wedsamuel1230/CTEA-BottleSumo/software/CAR/CAR_final/CAR_final_v2/README.md

# CAR_final - Dual-Core BottleSumo Robot

## Overview

This folder contains the complete implementation of a competition-ready bottle sumo robot using a dual-core architecture on the Raspberry Pi Pico W (RP2040).

## Quick Start

### 1. Hardware Requirements
- Raspberry Pi Pico W (RP2040)
- 2× DC Motors with H-Bridge drivers
- 5× VL53L0X Time-of-Flight sensors
- 1× ADS1115 16-bit ADC
- 4× QRE1113 IR reflectance sensors
- 2× Push buttons (optional, for test modes)
- Power supply (battery)

### 2. Upload Code
```bash
# Option A: Arduino IDE
Open CAR_final_v2.ino → Select "Raspberry Pi Pico W" → Upload

# Option B: arduino-cli
arduino-cli compile --fqbn rp2040:rp2040:rpipicow CAR_final_v2.ino
arduino-cli upload -p /dev/ttyACM0 --fqbn rp2040:rp2040:rpipicow
```

### 3. Connect & Monitor
```bash
# Serial monitor
screen /dev/ttyACM0 115200

# WiFi telemetry
nc 192.168.4.1 8080
```

### 4. Operation
1. Power on robot
2. Wait for "Ready" messages
3. Place in arena
4. Robot starts automatically after 3 seconds

## File Structure

```
CAR_final/
├── README.md                      # This file
├── CAR_final.ino                  # Original implementation (v1)
├── CAR_final_v2.ino              # NEW: Dual-core architecture (v2) ⭐
│
├── Car.cpp / Car.h                # Motor control abstraction
├── Motor.cpp / Motor.h            # Low-level PWM motor driver
├── ToFArray.cpp / ToFArray.h      # VL53L0X sensor array manager
├── Ads1115Sampler.cpp / .h        # ADS1115 ADC interface
├── ButtonManager.h                # Button debouncing utility
│
├── IMPLEMENTATION_SUMMARY.md      # High-level summary
├── DUAL_CORE_ARCHITECTURE.md      # Detailed architecture docs
├── MIGRATION_GUIDE.md             # v1 → v2 migration guide
├── QUICK_REFERENCE.md             # Developer quick reference
└── ARCHITECTURE_DIAGRAMS.md       # Visual diagrams
```

## Architecture

### Core 0: Pure State Machine (100Hz)
- **Input**: Sensor data from shared memory
- **Processing**: Decision logic (edge detection, target tracking)
- **Output**: Motor commands to shared memory
- **No I/O operations** - deterministic timing

### Core 1: Time-Sliced I/O Scheduler (500ms cycle)
- **10 time slots** @ 50ms each
- **IR sensors**: Read 4× per cycle (200Hz)
- **ToF sensors**: Read 1× per cycle per sensor (2Hz)
- **Motors**: Updated 2× per cycle
- **WiFi**: Telemetry broadcast 2× per cycle

### Shared Memory (Mutex-Protected)
```cpp
SensorData       // Core 1 → Core 0
MotorCommand     // Core 0 → Core 1
TelemetryData    // Both → WiFi
```

## Key Features

✅ **Non-blocking** - No blocking operations, smooth performance  
✅ **Deterministic** - Predictable timing for competition reliability  
✅ **Separation of Concerns** - Logic isolated from I/O  
✅ **Scalable** - Easy to add new features  
✅ **Robust** - Mutex-protected shared memory  
✅ **Maintainable** - Clean, well-documented code  
✅ **WiFi Telemetry** - Real-time monitoring and debugging  

## Pin Configuration

### Motors
```
Left Motor:  PWM=11, DIR=12
Right Motor: PWM=14, DIR=15
```

### ToF Sensors (I2C on Wire1)
```
SDA=2, SCL=3
XSHUT Pins: {8, 7, 6, 5, 4}
Addresses: {0x30, 0x31, 0x32, 0x33, 0x34}
Layout: [R45°, R23°, Center, L23°, L45°]
```

### IR Sensors (ADS1115 on Wire1)
```
Address: 0x48
Channels:
  A0 = Back-Left
  A1 = Front-Left
  A2 = Front-Right
  A3 = Back-Right
```

### Buttons (Optional)
```
Test Mode: Pin 16
Run Mode:  Pin 17
```

## States & Behavior

### State Machine
1. **IDLE** - Waiting for start command
2. **SEARCHING** - Spinning to find opponent
3. **TRACKING** - Aligning with target
4. **ATTACKING** - Full-speed forward attack
5. **EDGE_AVOIDING** - Emergency edge escape
6. **CALIBRATING** - Sensor calibration mode

### Priority System
```
1. Edge Detection ────────────► (Highest)
2. Target Tracking
3. Search Pattern ─────────────► (Default)
```

## Performance

### Response Times
- **Edge Detection**: 127-377ms
- **Target Tracking**: 450-703ms
- **State Transition**: <1ms

### CPU Utilization
- **Core 0**: ~1% (pure logic)
- **Core 1**: ~40% (all I/O)

### Sensor Update Rates
- **IR**: 200Hz (continuous)
- **ToF**: 2Hz per sensor
- **Motors**: 2Hz command updates

## WiFi Telemetry

### Connection
```
SSID:     BottleSumo_AP
Password: sumobot123456
IP:       192.168.4.1
Port:     8080
```

### JSON Format
```json
{
  "t": 12345,
  "ir": [0.12, 1.45, 1.50, 0.10],
  "tof": [120, 115, 110, 118, 125],
  "m": [35.0, 35.0],
  "s": 3
}
```

### Python Client Example
```python
import socket
import json

sock = socket.socket()
sock.connect(('192.168.4.1', 8080))

while True:
    data = sock.recv(1024).decode()
    for line in data.split('\n'):
        if line:
            telem = json.loads(line)
            print(f"State: {telem['s']}, Center ToF: {telem['tof'][2]}mm")
```

## Tuning Parameters

Located in `CAR_final_v2.ino`:

```cpp
// Detection
IR_THRESHOLD_FRONT = 1.5f   // Edge detection (volts)
IR_THRESHOLD_BACK = 3.0f    // Edge detection (volts)
DETECT_MIN_MM = 70          // Min ToF distance
DETECT_MAX_MM = 1000        // Max ToF distance

// Behavior
ESCAPE_SPEED = 50.0f        // Edge escape speed
ATTACK_SPEED = 100.0f       // Full attack speed
SEARCH_SPIN_SPEED = 35.0f   // Search rotation speed

// Timing
TIME_SLICE_MS = 50          // I/O slot duration
```

## Troubleshooting

### Motors Don't Respond
```bash
# Check Serial Monitor
Expected: "[CORE1] Motors OK"

# If failed:
1. Check motor pin connections
2. Verify power supply
3. Test motors independently
```

### Sensors Show Invalid
```bash
# Check Serial Monitor
Expected: "[CORE1] ToF sensors online: 5/5"
Expected: "[CORE1] ADS1115 OK"

# If failed:
1. Check I2C connections (SDA=2, SCL=3)
2. Verify sensor power
3. Run I2C scanner
```

### WiFi Won't Connect
```bash
# Check Serial Monitor
Expected: "[CORE1] WiFi AP: 192.168.4.1"

# If failed:
1. Check antenna connected
2. Verify SSID not conflicting
3. Try different channel
```

### Robot Stuck in One State
```bash
# Enable debug mode
In stateMachineUpdate(), add:
Serial.printf("State: %d, Edge: %d, Target: %d\n", 
              (int)gStateMachine.currentState, 
              edgeDetected, 
              targetDetected);
```

## Testing Checklist

- [ ] Compile without errors
- [ ] All sensors initialize (check Serial Monitor)
- [ ] Motors respond to commands
- [ ] WiFi AP visible
- [ ] Telemetry streams over WiFi
- [ ] Edge detection triggers avoidance
- [ ] Target tracking changes state
- [ ] 1-hour continuous operation
- [ ] Competition arena validation

## Documentation

### Quick Start
- **README.md** (this file) - Overview and quick start

### Development
- **QUICK_REFERENCE.md** - API, pins, parameters
- **ARCHITECTURE_DIAGRAMS.md** - Visual architecture diagrams

### Deep Dive
- **DUAL_CORE_ARCHITECTURE.md** - Complete design documentation
- **IMPLEMENTATION_SUMMARY.md** - High-level summary

### Migration
- **MIGRATION_GUIDE.md** - Upgrade from v1 to v2

## Version History

| Version | Date | Description |
|---|---|---|
| v1 | Original | Blocking architecture, mixed I/O and logic |
| v2 | Current | Dual-core time-sliced, pure state machine |

## Contributing

When modifying this code:

1. **Core 0 changes**: Pure logic only, no I/O
2. **Core 1 changes**: Ensure tasks fit in 50ms slots
3. **Shared memory**: Always use mutex protection
4. **Testing**: Validate timing with Serial Monitor
5. **Documentation**: Update relevant .md files

## Competition Tips

1. **Calibrate sensors** in the actual arena lighting
2. **Tune thresholds** for your arena surface
3. **Test edge detection** at all angles
4. **Validate target tracking** at various distances
5. **Run endurance tests** before competition
6. **Have backup configuration** ready

## Support

For issues or questions:

1. Check Serial Monitor output
2. Review QUICK_REFERENCE.md
3. Read DUAL_CORE_ARCHITECTURE.md
4. Check MIGRATION_GUIDE.md
5. Review code comments

## License

See LICENSE file in repository root.

## Credits

Developed for CTEA BottleSumo Competition

---

**Ready to compete! 🤖🥋**

For detailed architecture information, see **DUAL_CORE_ARCHITECTURE.md**  
For API reference, see **QUICK_REFERENCE.md**  
For migration help, see **MIGRATION_GUIDE.md**
