wedsamuel1230/CTEA-BottleSumo/software/BottleSumo_TimeSliced/edge_detection_architecture.png

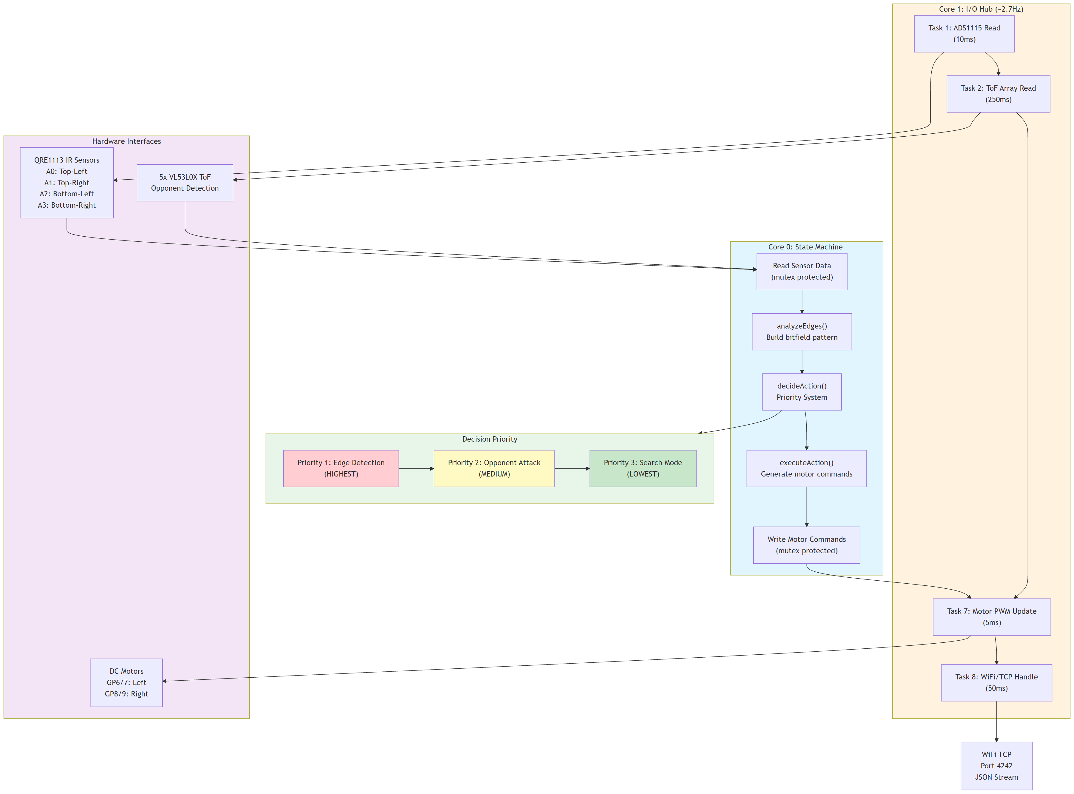
software/BottleSumo_TimeSliced/edge_detection_architecture.png
