wedsamuel1230/CTEA-BottleSumo/software/BottleSumo_TimeSliced/edge_pattern_flow.png

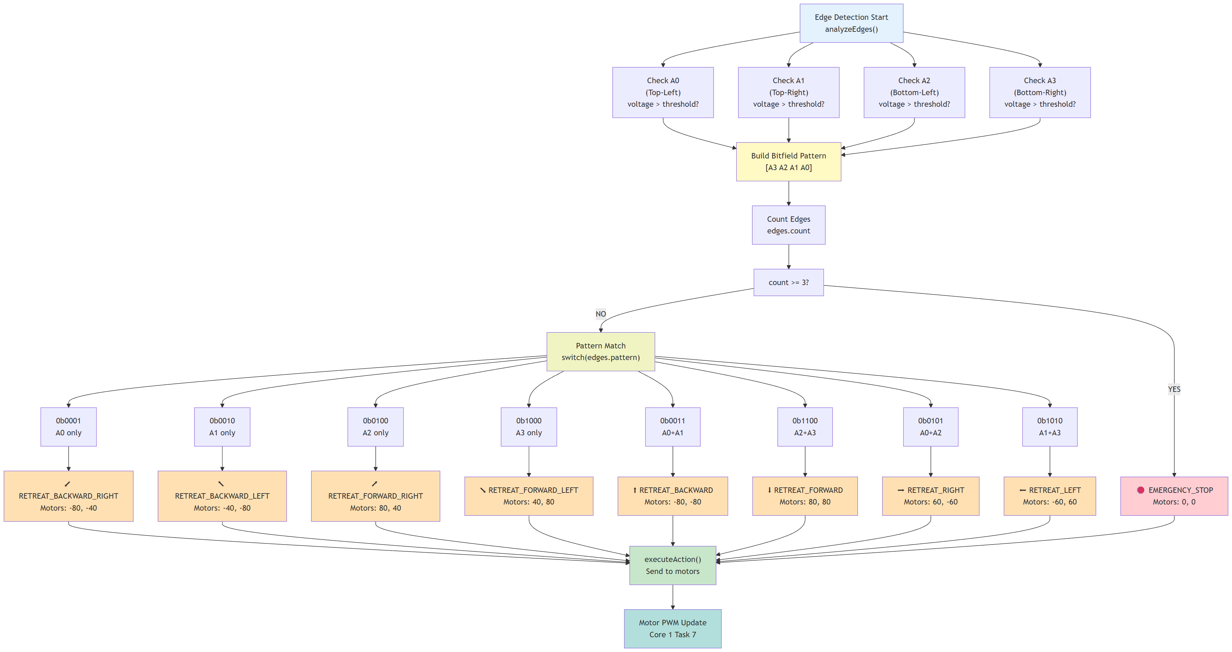
software/BottleSumo_TimeSliced/edge_pattern_flow.png
