wedsamuel1230/CTEA-BottleSumo/3dmodel/Car1_Front_Cover.obj

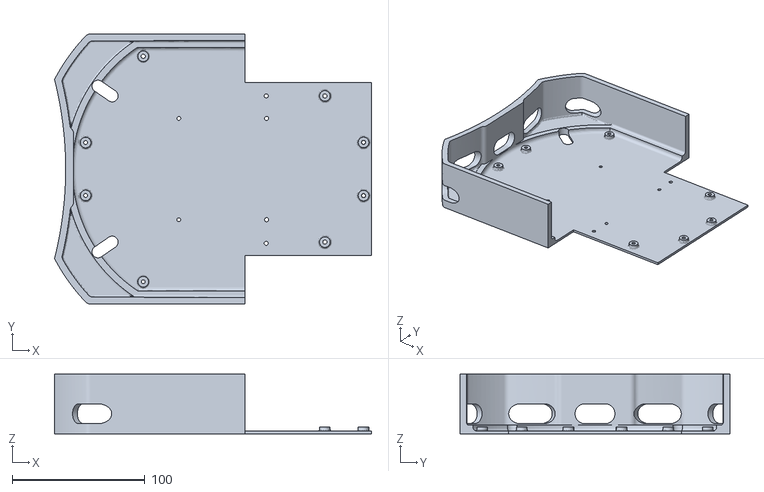
[picture p3: CAD file, 2025-12-06]
3dmodel/Car1_Front_Cover.obj
238.5 x 203.1 x 44.8
