wedsamuel1230/CTEA-BottleSumo/3dmodel/Car2_Front_Cover.obj

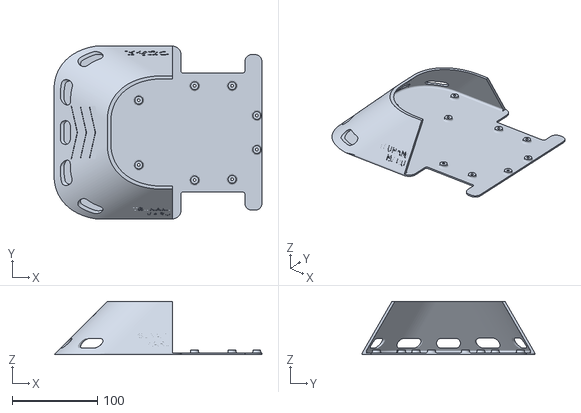
[picture p4: CAD file, 2025-12-06]
3dmodel/Car2_Front_Cover.obj
244.6 x 203.1 x 62.7
