wedsamuel1230/CTEA-BottleSumo/3dmodel/Car_Back_Cover.obj

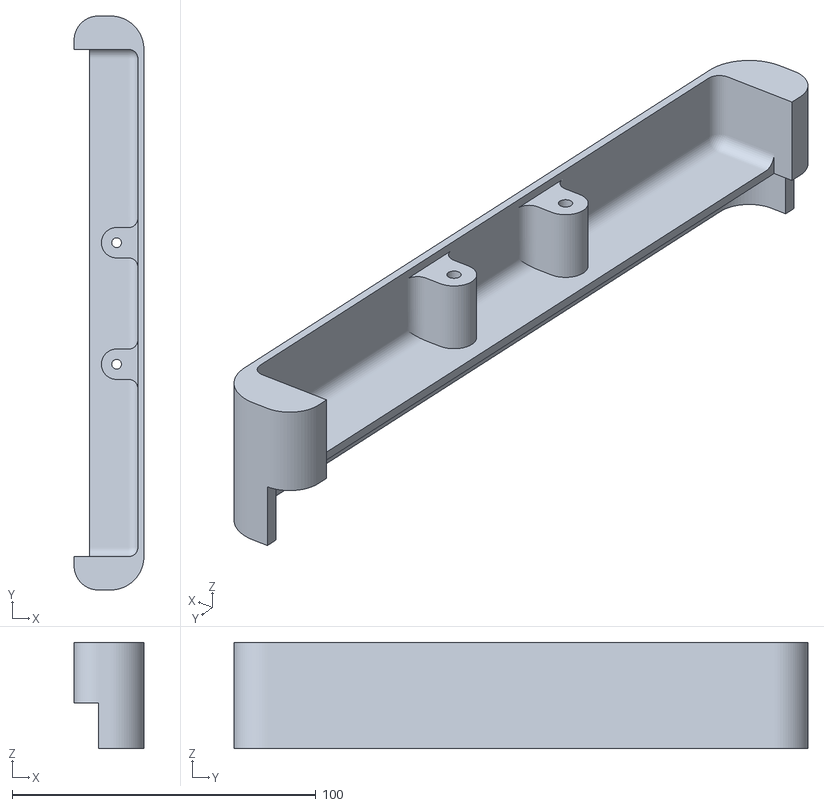
[picture p5: CAD file, 2025-12-06]
3dmodel/Car_Back_Cover.obj
23.0 x 189.0 x 35.0
