wedsamuel1230/CTEA-BottleSumo/pcb/main board.pdf

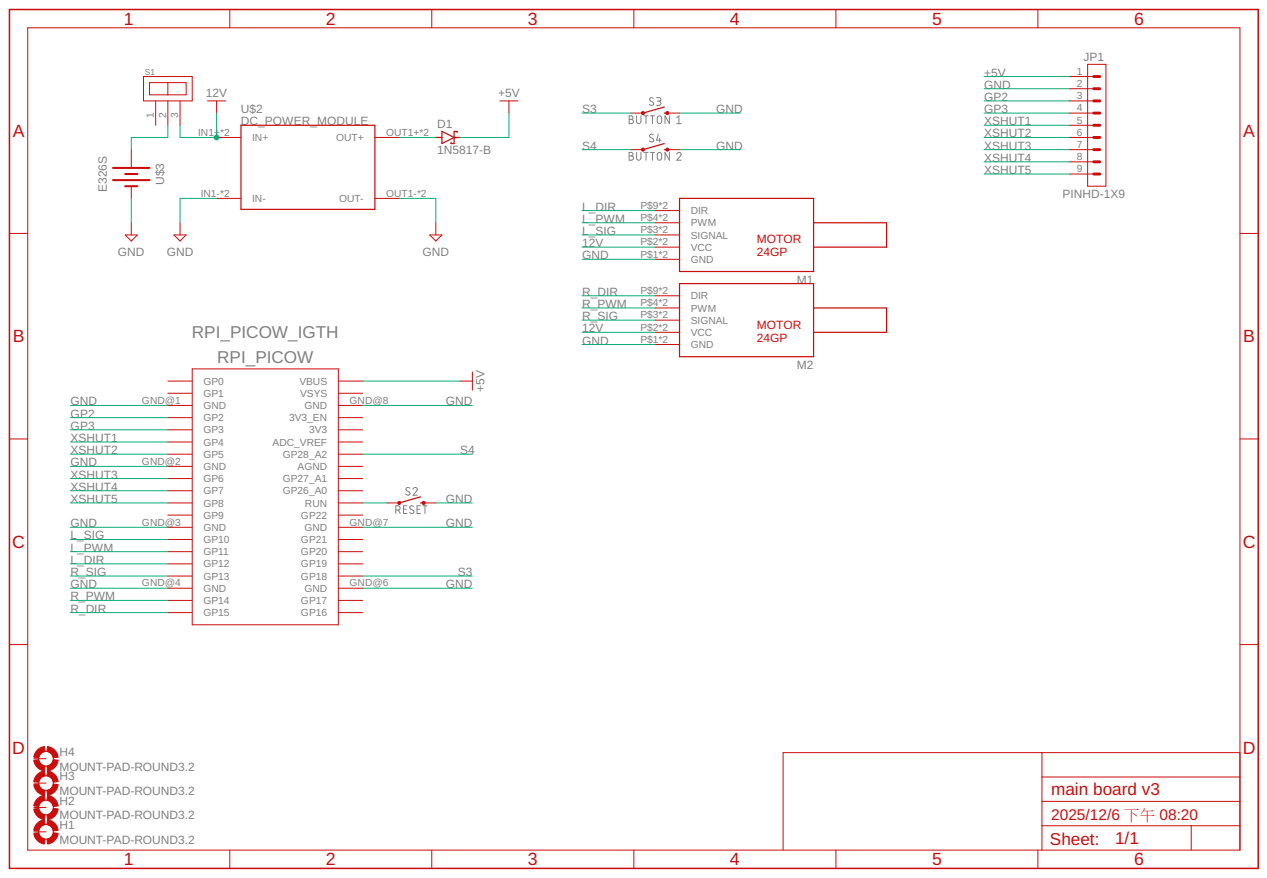
[picture p6: page 1]
DC_POWER_MODULE GND; GND E³²⁶S GND; +5V 1N5817-B+5V 12V MOUNT-PAD-ROUND3.2 MOUNT-PAD-ROUND3.2 MOUNT-PAD-ROUND3.2 MOUNT-PAD-ROUND3.2; PINHD-1X9 RPI_PICOW_IGTH GP0 GP1 GP2 GP3 GP4 GP5 GP6 GP7 GP8 GP9 GP10 GP11 GP12 GP13 GP14 GP15; GP16 GP17 GP18 GP19 GP20 GP21 GP22 RUN GP26_A0 GP27_A1 AGND GP28_A2 ADC_VREF 3V3 3V3_EN VSYS VBUS GND GND@1; GND GND@2; GND GND@3; GND GND@4; GND; GND@6 GND; GND@7 GND; GND@8 RPI_PICOW U$2IN+ IN1+*2; OUT-; OUT1-*2 OUT+; OUT1+*2 S11; M1 SIGNAL P$3*2; VCC P$2*2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

76.18

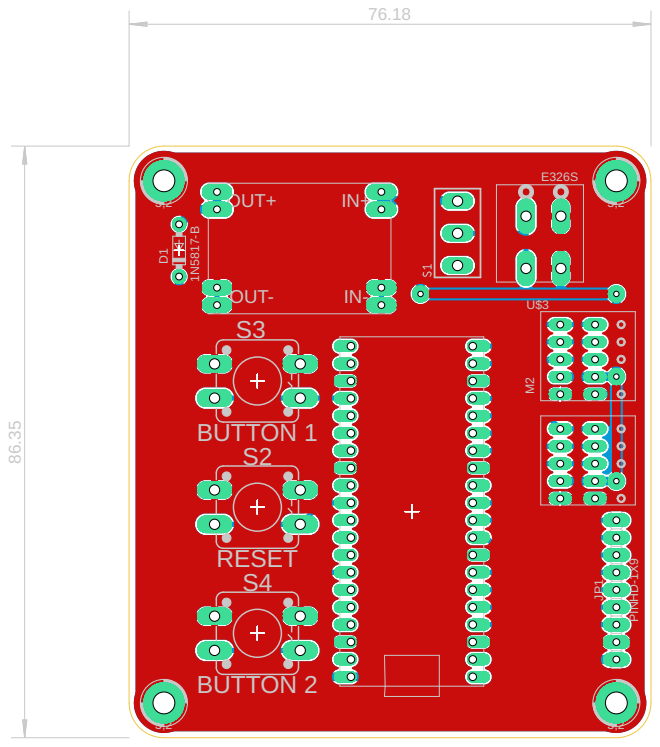
[picture p7: page 2]
OUT-; IN- OUT+; RESET; BUTTON 1; BUTTON 2; PINHD-1X9
