wedsamuel1230/CTEA-BottleSumo/pcb/sensor board.pdf

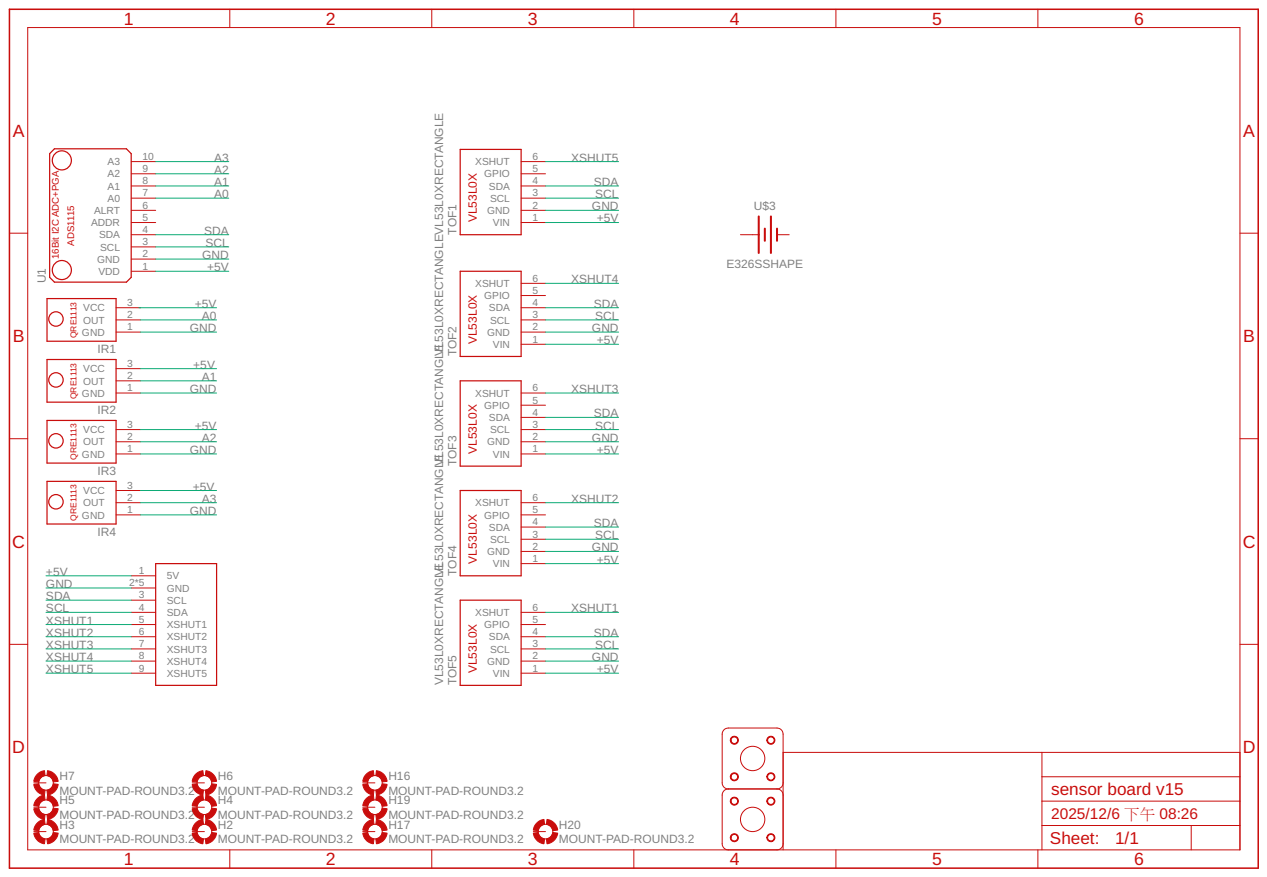
[picture p8: page 1]
MOUNT-PAD-ROUND3.2; VL53L0XRECTANGLE VL53L0XRECTANGLE VL53L0XRECTANGLE VL53L0XRECTANGLE VL53L0XRECTANGLE MOUNT-PAD-ROUND3.2; E326SSHAPE MOUNT-PAD-ROUND3.2 MOUNT-PAD-ROUND3.2; MOUNT-PAD-ROUND3.2 MOUNT-PAD-ROUND3.2 MOUNT-PAD-ROUND3.2; MOUNT-PAD-ROUND3.2 U¹; 7 ALRT; 6 ADDR; 5 SDA; 4 SCL; 3 GND; 2 VDD; 1 IR1 GND; 1 OUT; 2 VCC; 3 IR2 GND; 3 IR3 GND; 3 IR4 GND; GND 2*5; SCL 3; SDA 4; XSHUT1 5; XSHUT2 6; XSHUT3 7; XSHUT4 8; XSHUT5 9 H3; TOF1; VIN; 1 GND; 2 SCL; 3 SDA; 4 GPIO; 5 XSHUT; 6 TOF2; 6 TOF3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

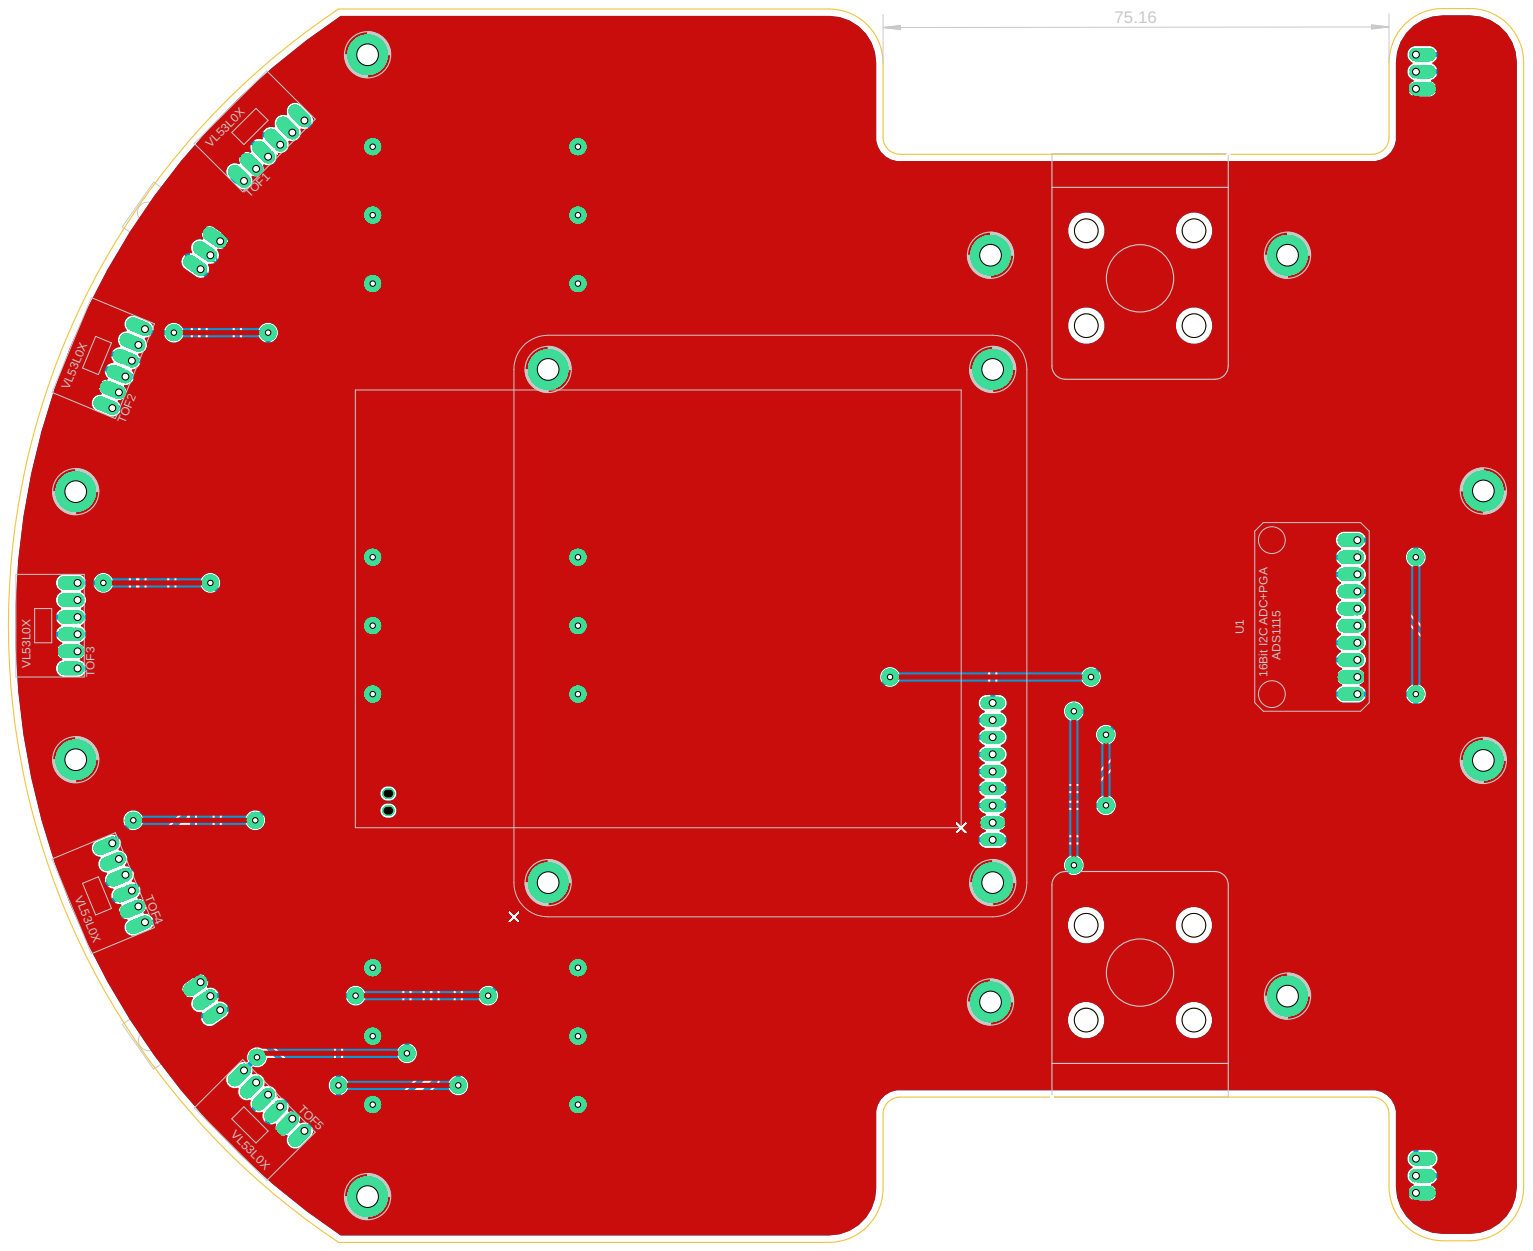
[picture p9: page 2]

1 RI RI 2 RI 3 4 RI QRE1113 QRE1 3 QRE1 3 QRE1113 16Bit I2C ADC+PGA ADS1115 VL53L0X VL53L0X VL53L0X VL53L0X VL53L0X U1 TOF1 TOF2 TOF3 TOF4 TOF5 75.16
