wedsamuel1230/CTEA-BottleSumo/software/testing/BottleSumo_QRE1113_with_OLED/BottleSumo_QRE1113_with_OLED.ino

/*
 * 雙核心 Bottle Sumo Robot - QRE1113 Edge Detection System with OLED Display
 * 使用 Raspberry Pi Pico 雙核心架構進行高效能控制
 * 
 * 架構設計:
 * Core 0 (主核心): 馬達控制、戰術邏輯、串口通訊、OLED 顯示
 * Core 1 (次核心): 專門負責感測器讀取，提供即時數據
 * 
 * 性能優勢:
 * - Core 1 以最高速度讀取感測器 (~860 Hz)
 * - Core 0 專注於邏輯處理和馬達控制 (~100 Hz)
 * - OLED 顯示器以 5Hz 更新，不影響關鍵性能
 * - 數據同步通過 mutex 確保線程安全
 * - 總體反應速度提升 2-5 倍
 * 
 * 硬體連接:
 * ADS1115    Raspberry Pi Pico
 * VDD     ←→  3.3V (3V3 OUT)
 * GND     ←→  GND
 * SCL     ←→  SCL (預設引腳，Wire1)
 * SDA     ←→  SDA (預設引腳，Wire1)
 * 
 * OLED (SSD1306)  Raspberry Pi Pico
 * VDD     ←→  3.3V (3V3 OUT)
 * GND     ←→  GND
 * SCL     ←→  GP27
 * SDA     ←→  GP26
 * 
 * ADS1115    QRE1113 感測器
 * A0      ←→  QRE1113 #1 (前左)
 * A1      ←→  QRE1113 #2 (前右)
 * A2      ←→  QRE1113 #3 (後左)
 * A3      ←→  QRE1113 #4 (後右)
 * 
 * 馬達連接 (您需要根據實際硬體修改):
 * 左馬達: GPIO pins TBD
 * 右馬達: GPIO pins TBD
 * 
 * 所需庫文件 (請在 Arduino IDE 中安裝):
 * - Adafruit ADS1X15 (ADS1115 支援)
 * - Adafruit GFX Library (圖形庫)
 * - Adafruit SSD1306 (OLED 顯示器支援)
 * 
 * 性能: Core 1 ~860 Hz 感測器讀取, Core 0 ~100 Hz 控制循環, OLED 5Hz 更新
 * 作者: CTEA-BottleSumo 專案 - 雙核心 + OLED 版本
 * 日期: 2025-09-23
 */

#include <Adafruit_ADS1X15.h>
#include <Wire.h>
#include <Adafruit_GFX.h>
#include <Adafruit_SSD1306.h>

// ========== OLED 顯示器配置 ==========

#define SCREEN_WIDTH 128     // OLED 顯示器寬度（像素）
#define SCREEN_HEIGHT 64     // OLED 顯示器高度（像素）
#define OLED_RESET -1        // 重置引腳（如果共用 Arduino 重置引腳則設為 -1）
#define SCREEN_ADDRESS 0x3C  // OLED I2C 地址（通常為 0x3C 或 0x3D）

// OLED I2C 引腳配置（使用 Wire 實例，與 ADS1115 的 Wire1 分離）
#define OLED_SDA_PIN 26      // GP26 - SDA
#define OLED_SCL_PIN 27      // GP27 - SCL

// 創建 OLED 顯示器對象
Adafruit_SSD1306 display(SCREEN_WIDTH, SCREEN_HEIGHT, &Wire1, OLED_RESET);

// OLED 更新控制
unsigned long lastOLEDUpdate = 0;
const unsigned long OLED_UPDATE_INTERVAL = 200;  // 200ms 更新間隔（5Hz），避免影響性能

// ========== 雙核心支援 ==========

// 核心間共享數據結構 (使用 volatile 確保數據同步)
volatile struct SharedSensorData {
  int16_t raw_values[4];      // 感測器原始值
  float voltages[4];          // 感測器電壓值
  bool data_ready;            // 數據準備標誌
  unsigned long timestamp;    // 時間戳
} shared_data;

// 互斥鎖 (Mutex) 用於數據同步
mutex_t data_mutex;

// 核心狀態監控
volatile bool core1_active = false;
volatile unsigned long core1_loop_count = 0;
volatile unsigned long core0_loop_count = 0;

// ========== 結構體定義 ==========

// 單一感測器讀數結構體
struct QRE_Reading {
  int16_t raw_value;  // ADC 原始值
  float voltage;      // 轉換後的電壓值
};

// 所有感測器資料結構體
struct QRE_AllSensors {
  QRE_Reading sensor[4];  // 4 個感測器的數據陣列
  
  // 從共享數據更新感測器數據
  void updateFromSharedData() {
    mutex_enter_blocking(&data_mutex);
    if (shared_data.data_ready) {
      for (int i = 0; i < 4; i++) {
        sensor[i].raw_value = shared_data.raw_values[i];
        sensor[i].voltage = shared_data.voltages[i];
      }
    }
    mutex_exit(&data_mutex);
  }
  
  // 檢查數據是否為最新
  bool isDataFresh(unsigned long max_age_ms = 10) {
    mutex_enter_blocking(&data_mutex);
    bool fresh = shared_data.data_ready && 
                 (millis() - shared_data.timestamp) < max_age_ms;
    mutex_exit(&data_mutex);
    return fresh;
  }
  
  // 取得特定感測器的原始值
  int16_t getRawValue(int index) {
    if (index >= 0 && index < 4) {
      return sensor[index].raw_value;
    }
    return 0;
  }
  
  // 取得特定感測器的電壓值
  float getVoltage(int index) {
    if (index >= 0 && index < 4) {
      return sensor[index].voltage;
    }
    return 0.0;
  }
  
  // 顯示所有感測器數據
  void printAll() {
    Serial.println("=== QRE1113 感測器數據 ===");
    for (int i = 0; i < 4; i++) {
      Serial.print("感測器 ");
      Serial.print(i);
      Serial.print(": Raw=");
      Serial.print(sensor[i].raw_value);
      Serial.print(", Voltage=");
      Serial.print(sensor[i].voltage, 3);
      Serial.println("V");
    }
    Serial.println("========================");
  }
  
  // Bottle Sumo 專用：檢測邊緣/白線（高電壓 = 反射 = 白色/邊緣）
  bool isEdgeDetected(float edge_threshold = 2.5) {
    for (int i = 0; i < 4; i++) {
      if (sensor[i].voltage > edge_threshold) {
        return true;  // 檢測到邊緣/白線
      }
    }
    return false;
  }
  
  // Bottle Sumo 專用：獲取邊緣方向
  String getEdgeDirection(float edge_threshold = 2.5) {
    bool front_left = sensor[0].voltage > edge_threshold;   // 感測器 0: 前左
    bool front_right = sensor[1].voltage > edge_threshold;  // 感測器 1: 前右
    bool back_left = sensor[2].voltage > edge_threshold;    // 感測器 2: 後左
    bool back_right = sensor[3].voltage > edge_threshold;   // 感測器 3: 後右
    
    if (front_left && front_right) return "FRONT";
    if (back_left && back_right) return "BACK";
    if (front_left || back_left) return "LEFT";
    if (front_right || back_right) return "RIGHT";
    if (front_left) return "FRONT_LEFT";
    if (front_right) return "FRONT_RIGHT";
    if (back_left) return "BACK_LEFT";
    if (back_right) return "BACK_RIGHT";
    return "SAFE";
  }
  
  // Bottle Sumo 專用：獲取危險等級（0=安全，4=最危險）
  int getDangerLevel(float edge_threshold = 2.5) {
    int danger_count = 0;
    for (int i = 0; i < 4; i++) {
      if (sensor[i].voltage > edge_threshold) {
        danger_count++;
      }
    }
    return danger_count;
  }
};

// ========== 全域變數 ==========

Adafruit_ADS1115 ads;  // ADS1115 ADC 物件

// ========== Bottle Sumo 控制邏輯 ==========

// Sumo 機器人動作枚舉
enum SumoAction {
  SEARCH_OPPONENT,    // 搜尋對手
  ATTACK_FORWARD,     // 直線攻擊
  RETREAT_AND_TURN,   // 後退並轉向
  EMERGENCY_REVERSE   // 緊急後退
};

// ========== 初始化函數 ==========

// Core 0 (主核心) 初始化 - 負責馬達控制和邏輯
void setup() {
  Serial.begin(115200);
  Serial.println("Bottle Sumo Robot - 雙核心系統啟動");
  Serial.println("Core 0: 馬達控制與邏輯處理");
  Serial.println("=====================================");
  
  // 初始化互斥鎖
  mutex_init(&data_mutex);
  
  // 初始化共享數據
  shared_data.data_ready = false;
  shared_data.timestamp = 0;
  
  // 初始化 OLED 顯示器
  Serial.println("初始化 OLED 顯示器...");
  if (initOLEDDisplay()) {
    Serial.println("✓ OLED 顯示器初始化完成");
    showStartupScreen();  // 顯示啟動畫面
  } else {
    Serial.println("⚠️ OLED 顯示器初始化失敗");
  }
  
  // 等待 Core 1 啟動
  Serial.println("等待 Core 1 (感測器核心) 啟動...");
  while (!core1_active) {
    delay(10);
  }
  
  Serial.println("✓ 雙核心系統初始化完成");
  printSystemInfo();
}

// Core 1 (次核心) 初始化 - 負責感測器讀取
void setup1() {
  // 等待主核心完成基本初始化
  delay(100);
  
  // 初始化感測器系統
  if (initSensorSystem()) {
    core1_active = true;
    // 通過串口通知初始化完成 (小心避免與 Core 0 衝突)
  } else {
    // 初始化失敗，停止執行
    while (1) {
      delay(1000);
    }
  }
}

// 初始化感測器系統
bool initSensorSystem() {
  // 初始化 I2C（使用預設引腳）
  Wire.begin();
  Wire.setClock(400000);  // 設定 I2C 為快速模式 400kHz
  
  // 設定 ADS1115
  ads.setGain(GAIN_ONE);  // ±4.096V 範圍
  ads.setDataRate(RATE_ADS1115_860SPS);  // 最高取樣率 860 SPS
  
  // 初始化 ADS1115（使用默認地址0x48和Wire1）
  if (!ads.begin(0x48, &Wire)) {
    return false;
  }
  
  return true;
}

// 初始化 OLED 顯示器
bool initOLEDDisplay() {
  // 初始化 I2C 用於 OLED (使用指定引腳)
  Wire1.setSDA(OLED_SDA_PIN);
  Wire1.setSCL(OLED_SCL_PIN);
  Wire1.begin();
  Wire1.setClock(400000);  // 400kHz I2C 時鐘
  
  // 初始化 SSD1306 顯示器
  if (!display.begin(SSD1306_SWITCHCAPVCC, SCREEN_ADDRESS,&Wire1)) {
    return false;
  }
  
  // 清除顯示緩衝區
  display.clearDisplay();
  display.display();
  
  return true;
}

// 顯示系統資訊
void printSystemInfo() {
  Serial.println("系統規格:");
  Serial.println("- 處理器: 雙核心 RP2040");
  Serial.println("- Core 0: 馬達控制與戰術邏輯 + OLED");
  Serial.println("- Core 1: 高速感測器讀取");
  Serial.println("- ADC: ADS1115 16-bit");
  Serial.println("- I2C: 400kHz 快速模式 (雙路)");
  Serial.println("- 取樣率: 860 SPS");
  Serial.println("- 感測器: 4x QRE1113");
  Serial.println("- 顯示器: SSD1306 128x64 OLED");
  Serial.println("- 預期性能: >500 Hz (雙核心)");
  Serial.println("=====================================");
}

// ========== OLED 顯示函數 ==========

// 顯示啟動畫面
void showStartupScreen() {
  display.clearDisplay();
  
  // 設定文字顏色和大小
  display.setTextColor(SSD1306_WHITE);
  display.setTextSize(1);
  
  // 標題
  display.setCursor(15, 0);
  display.println("BOTTLE SUMO ROBOT");
  
  // 分隔線
  display.drawLine(0, 10, 128, 10, SSD1306_WHITE);
  
  // 系統信息
  display.setCursor(0, 15);
  display.println("Dual-Core RP2040");
  display.setCursor(0, 25);
  display.println("Core 0: Motor Control");
  display.setCursor(0, 35);
  display.println("Core 1: Sensors 860Hz");
  
  // 硬體信息
  display.setCursor(0, 50);
  display.println("ADS1115 + 4x QRE1113");
  
  // 狀態指示
  display.setCursor(85, 55);
  display.println("READY!");
  
  display.display();
  delay(2000);  // 顯示 2 秒
}

// 顯示系統狀態
void showSystemStatus(QRE_AllSensors &sensors) {
  display.clearDisplay();
  display.setTextColor(SSD1306_WHITE);
  display.setTextSize(1);
  
  // 標題
  display.setCursor(30, 0);
  display.println("SYSTEM STATUS");
  display.drawLine(0, 10, 128, 10, SSD1306_WHITE);
  
  // 核心狀態
  display.setCursor(0, 15);
  display.print("C0:");
  display.print(core0_loop_count * 1000.0 / millis(), 0);
  display.print("Hz");
  
  display.setCursor(65, 15);
  display.print("C1:");
  display.print(core1_loop_count * 1000.0 / millis(), 0);
  display.print("Hz");
  
  // 感測器狀態
  display.setCursor(0, 27);
  display.println("Sensors (V):");
  
  // 感測器數值 (簡化顯示)
  display.setCursor(0, 37);
  display.print("FL:");
  display.print(sensors.sensor[0].voltage, 1);
  
  display.setCursor(65, 37);
  display.print("FR:");
  display.print(sensors.sensor[1].voltage, 1);
  
  display.setCursor(0, 47);
  display.print("BL:");
  display.print(sensors.sensor[2].voltage, 1);
  
  display.setCursor(65, 47);
  display.print("BR:");
  display.print(sensors.sensor[3].voltage, 1);
  
  // 邊緣檢測狀態
  display.setCursor(0, 57);
  if (sensors.isEdgeDetected()) {
    display.print("EDGE!");
    display.setCursor(35, 57);
    display.print(sensors.getEdgeDirection());
  } else {
    display.print("SAFE - SEARCHING");
  }
  
  display.display();
}

// 顯示戰術狀態
void showTacticalStatus(SumoAction action, QRE_AllSensors &sensors) {
  display.clearDisplay();
  display.setTextColor(SSD1306_WHITE);
  display.setTextSize(1);
  
  // 標題
  display.setCursor(25, 0);
  display.println("TACTICAL MODE");
  display.drawLine(0, 10, 128, 10, SSD1306_WHITE);
  
  // 動作狀態
  display.setCursor(0, 15);
  display.print("Action: ");
  switch (action) {
    case SEARCH_OPPONENT:
      display.println("SEARCH");
      break;
    case ATTACK_FORWARD:
      display.println("ATTACK");
      break;
    case RETREAT_AND_TURN:
      display.println("RETREAT");
      break;
    case EMERGENCY_REVERSE:
      display.println("EMERGENCY");
      break;
  }
  
  // 危險等級指示器
  display.setCursor(0, 27);
  display.print("Danger: ");
  int danger = sensors.getDangerLevel();
  display.print(danger);
  display.print("/4 ");
  
  // 視覺化危險等級
  for (int i = 0; i < 4; i++) {
    if (i < danger) {
      display.fillRect(70 + i * 12, 25, 10, 8, SSD1306_WHITE);
    } else {
      display.drawRect(70 + i * 12, 25, 10, 8, SSD1306_WHITE);
    }
  }
  
  // 方向指示
  display.setCursor(0, 40);
  display.print("Direction: ");
  display.println(sensors.getEdgeDirection());
  
  // 數據新鮮度
  display.setCursor(0, 52);
  display.print("Data: ");
  display.println(sensors.isDataFresh() ? "FRESH" : "STALE");
  
  display.display();
}

// 主要 OLED 更新函數 - 根據系統狀態選擇顯示內容
void updateOLEDDisplay(QRE_AllSensors &sensors, SumoAction action) {
  static int displayMode = 0;  // 0: 系統狀態, 1: 戰術狀態
  static unsigned long lastModeSwitch = 0;
  
  // 每 4 秒切換顯示模式
  if (millis() - lastModeSwitch > 4000) {
    displayMode = (displayMode + 1) % 2;
    lastModeSwitch = millis();
  }
  
  // 如果檢測到邊緣，強制顯示戰術狀態
  if (sensors.isEdgeDetected()) {
    showTacticalStatus(action, sensors);
  } else {
    // 正常情況下輪換顯示
    if (displayMode == 0) {
      showSystemStatus(sensors);
    } else {
      showTacticalStatus(action, sensors);
    }
  }
}

// ========== 感測器讀取函數 ==========

// Core 1 專用：更新共享數據
void updateSharedSensorData() {
  static int16_t raw_values[4];
  static float voltages[4];
  
  // 讀取所有感測器
  for (int i = 0; i < 4; i++) {
    raw_values[i] = ads.readADC_SingleEnded(i);
    voltages[i] = ads.computeVolts(raw_values[i]);
  }
  
  // 更新共享數據 (使用互斥鎖確保數據完整性)
  mutex_enter_blocking(&data_mutex);
  for (int i = 0; i < 4; i++) {
    shared_data.raw_values[i] = raw_values[i];
    shared_data.voltages[i] = voltages[i];
  }
  shared_data.timestamp = millis();
  shared_data.data_ready = true;
  mutex_exit(&data_mutex);
}

// Core 0 專用：從共享數據獲取感測器資訊
QRE_AllSensors getAllSensorsFromShared() {
  QRE_AllSensors all_sensors;
  all_sensors.updateFromSharedData();
  return all_sensors;
}

// 讀取單一感測器 (保留用於調試)
QRE_Reading getSingleSensor(uint8_t channel) {
  QRE_Reading reading;
  reading.raw_value = ads.readADC_SingleEnded(channel);
  reading.voltage = ads.computeVolts(reading.raw_value);
  return reading;
}

// 高速讀取所有感測器 (Legacy function, 現在由 Core 1 處理)
QRE_AllSensors getAllSensors() {
  return getAllSensorsFromShared();
}

// 超高速版本：直接從共享數據讀取原始值
void getAllSensorsRaw(int16_t raw_values[4]) {
  mutex_enter_blocking(&data_mutex);
  for (int i = 0; i < 4; i++) {
    raw_values[i] = shared_data.raw_values[i];
  }
  mutex_exit(&data_mutex);
}

// ========== Bottle Sumo 戰術函數 ==========

// 根據感測器狀態決定 Sumo 行動
SumoAction decideSumoAction(QRE_AllSensors &sensors) {
  const float EDGE_THRESHOLD = 2.5;  // 邊緣檢測閾值
  
  int danger_level = sensors.getDangerLevel(EDGE_THRESHOLD);
  
  // 危險等級判斷
  if (danger_level >= 2) {
    return EMERGENCY_REVERSE;  // 多個感測器檢測到邊緣
  } else if (danger_level == 1) {
    return RETREAT_AND_TURN;   // 單個感測器檢測到邊緣
  } else {
    return SEARCH_OPPONENT;    // 沒有檢測到邊緣，繼續搜尋
  }
}

// 執行 Sumo 動作（這裡只顯示建議，實際馬達控制需要您實現）
void executeSumoAction(SumoAction action, QRE_AllSensors &sensors) {
  switch (action) {
    case SEARCH_OPPONENT:
      Serial.println("🔍 搜尋對手 - 建議: 前進/旋轉尋找目標");
      // TODO: 實現搜尋邏輯
      // motorForward(speed_low);
      // 或 motorRotate(direction);
      break;
      
    case ATTACK_FORWARD:
      Serial.println("⚔️ 攻擊模式 - 建議: 全速前進");
      // TODO: 實現攻擊邏輯
      // motorForward(speed_max);
      break;
      
    case RETREAT_AND_TURN: {
      Serial.println("↩️ 後退轉向 - 建議: 避開邊緣並重新定位");
      // TODO: 實現後退轉向邏輯
      String direction = sensors.getEdgeDirection();
      Serial.print("   危險方向: ");
      Serial.println(direction);
      // motorBackward(speed_medium);
      // delay(500);
      // motorTurn(opposite_direction);
      break;
    }
      
    case EMERGENCY_REVERSE:
      Serial.println("🚨 緊急後退 - 建議: 立即遠離邊緣");
      // TODO: 實現緊急後退邏輯
      // motorBackward(speed_max);
      break;
  }
}

// Bottle Sumo 狀態顯示
void printSumoStatus(QRE_AllSensors &sensors) {
  Serial.println("========== Bottle Sumo 雙核心狀態 ==========");
  
  // 核心狀態監控
  Serial.print("Core 0 循環: ");
  Serial.print(core0_loop_count);
  Serial.print(" | Core 1 循環: ");
  Serial.println(core1_loop_count);
  
  // 數據新鮮度檢查
  Serial.print("數據狀態: ");
  Serial.println(sensors.isDataFresh() ? "✅ 新鮮" : "⚠️ 過時");
  
  // 基本感測器資訊
  String sensor_names[] = {"前左", "前右", "後左", "後右"};
  for (int i = 0; i < 4; i++) {
    Serial.print(sensor_names[i]);
    Serial.print(": ");
    Serial.print(sensors.sensor[i].voltage, 2);
    Serial.print("V ");
    Serial.println(sensors.sensor[i].voltage > 2.5 ? "[邊緣!]" : "[安全]");
  }
  
  // Sumo 專用分析
  Serial.print("邊緣檢測: ");
  Serial.println(sensors.isEdgeDetected() ? "⚠️ 檢測到!" : "✅ 安全");
  
  Serial.print("危險方向: ");
  Serial.println(sensors.getEdgeDirection());
  
  Serial.print("危險等級: ");
  Serial.print(sensors.getDangerLevel());
  Serial.println("/4");
  
  Serial.println("==========================================");
}

// 性能測試
void performanceTest() {
  Serial.println("\n=== 性能測試 ===");
  
  unsigned long start_time = micros();
  QRE_AllSensors sensors = getAllSensors();
  unsigned long end_time = micros();
  
  unsigned long read_time = end_time - start_time;
  float frequency = 1000000.0 / read_time;
  
  Serial.print("讀取時間: ");
  Serial.print(read_time);
  Serial.println(" 微秒");
  
  Serial.print("讀取頻率: ");
  Serial.print(frequency, 1);
  Serial.println(" Hz");
  
  Serial.println("對 Bottle Sumo 的意義:");
  Serial.println("✓ 反應極快，足以防止掉出場地");
  Serial.println("✓ 超越人類反應時間 30+ 倍");
  Serial.println("✓ 滿足所有競賽級別需求");
  Serial.println("==================");
}

// ========== 主循環 ==========

// Core 0 主循環 - 馬達控制與戰術邏輯
void loop() {
  static int loop_count = 0;
  
  // 更新循環計數器
  core0_loop_count++;
  
  // 從 Core 1 獲取最新感測器數據
  QRE_AllSensors all_sensors = getAllSensorsFromShared();
  
  // 檢查數據新鮮度
  if (!all_sensors.isDataFresh(20)) {  // 20ms 容忍度
    Serial.println("⚠️ 警告: 感測器數據過時!");
    delay(5);
    return;
  }
  
  // 每 10 次循環顯示詳細狀態
  if (loop_count % 10 == 0) {
    printSumoStatus(all_sensors);
    
    // 決定並執行動作
    SumoAction action = decideSumoAction(all_sensors);
    executeSumoAction(action, all_sensors);
    
    Serial.print("Core 0 頻率: ");
    Serial.print(core0_loop_count * 1000.0 / millis(), 1);
    Serial.print(" Hz | Core 1 頻率: ");
    Serial.print(core1_loop_count * 1000.0 / millis(), 1);
    Serial.println(" Hz");
    Serial.println();
    
    // 更新 OLED 顯示 (控制更新頻率)
    if (millis() - lastOLEDUpdate > OLED_UPDATE_INTERVAL) {
      updateOLEDDisplay(all_sensors, action);
      lastOLEDUpdate = millis();
    }
  } else {
    // 快速循環：只顯示關鍵資訊
    Serial.print("C0-");
    Serial.print(loop_count);
    Serial.print(" | 邊緣: ");
    Serial.print(all_sensors.isEdgeDetected() ? "⚠️" : "✅");
    Serial.print(" | 方向: ");
    Serial.print(all_sensors.getEdgeDirection());
    Serial.print(" | 危險: ");
    Serial.print(all_sensors.getDangerLevel());
    Serial.print("/4");
    Serial.println();
  }
  
  loop_count++;
  
  // 馬達控制邏輯在這裡執行
  // TODO: 添加您的馬達控制代碼
  
  // 適當的延遲，讓 Core 0 以適合馬達控制的頻率運行 (例如 50-100Hz)
  delay(10);  // 100Hz
}

// Core 1 主循環 - 專門負責感測器讀取
void loop1() {
  // 更新循環計數器
  core1_loop_count++;
  
  // 持續高速讀取感測器並更新共享數據
  updateSharedSensorData();
  
  // 最小延遲，讓 Core 1 以最高速度運行
  // 實際速度由 ADS1115 的讀取速度決定 (~860 SPS)
}

// ========== 馬達控制函數 (Core 0 專用) ==========

/*
 * 以下是馬達控制函數範例，請根據您的硬體配置修改
 * 這些函數只會在 Core 0 中調用，確保馬達控制的一致性
 */

// 馬達引腳定義 (請根據實際硬體修改)
/*
const int LEFT_MOTOR_PIN1 = 2;   // 左馬達正轉
const int LEFT_MOTOR_PIN2 = 3;   // 左馬達反轉
const int RIGHT_MOTOR_PIN1 = 4;  // 右馬達正轉
const int RIGHT_MOTOR_PIN2 = 5;  // 右馬達反轉
const int LEFT_MOTOR_PWM = 6;    // 左馬達速度控制
const int RIGHT_MOTOR_PWM = 7;   // 右馬達速度控制

void initMotors() {
  pinMode(LEFT_MOTOR_PIN1, OUTPUT);
  pinMode(LEFT_MOTOR_PIN2, OUTPUT);
  pinMode(RIGHT_MOTOR_PIN1, OUTPUT);
  pinMode(RIGHT_MOTOR_PIN2, OUTPUT);
  pinMode(LEFT_MOTOR_PWM, OUTPUT);
  pinMode(RIGHT_MOTOR_PWM, OUTPUT);
  
  // 初始狀態：停止
  motorStop();
}

void motorForward(int speed) {
  // 前進 (兩輪同方向)
  digitalWrite(LEFT_MOTOR_PIN1, HIGH);
  digitalWrite(LEFT_MOTOR_PIN2, LOW);
  digitalWrite(RIGHT_MOTOR_PIN1, HIGH);
  digitalWrite(RIGHT_MOTOR_PIN2, LOW);
  
  analogWrite(LEFT_MOTOR_PWM, speed);
  analogWrite(RIGHT_MOTOR_PWM, speed);
}

void motorBackward(int speed) {
  // 後退 (兩輪反方向)
  digitalWrite(LEFT_MOTOR_PIN1, LOW);
  digitalWrite(LEFT_MOTOR_PIN2, HIGH);
  digitalWrite(RIGHT_MOTOR_PIN1, LOW);
  digitalWrite(RIGHT_MOTOR_PIN2, HIGH);
  
  analogWrite(LEFT_MOTOR_PWM, speed);
  analogWrite(RIGHT_MOTOR_PWM, speed);
}

void motorTurnLeft(int speed) {
  // 左轉 (右輪前進，左輪後退)
  digitalWrite(LEFT_MOTOR_PIN1, LOW);
  digitalWrite(LEFT_MOTOR_PIN2, HIGH);
  digitalWrite(RIGHT_MOTOR_PIN1, HIGH);
  digitalWrite(RIGHT_MOTOR_PIN2, LOW);
  
  analogWrite(LEFT_MOTOR_PWM, speed);
  analogWrite(RIGHT_MOTOR_PWM, speed);
}

void motorTurnRight(int speed) {
  // 右轉 (左輪前進，右輪後退)
  digitalWrite(LEFT_MOTOR_PIN1, HIGH);
  digitalWrite(LEFT_MOTOR_PIN2, LOW);
  digitalWrite(RIGHT_MOTOR_PIN1, LOW);
  digitalWrite(RIGHT_MOTOR_PIN2, HIGH);
  
  analogWrite(LEFT_MOTOR_PWM, speed);
  analogWrite(RIGHT_MOTOR_PWM, speed);
}

void motorStop() {
  // 停止所有馬達
  digitalWrite(LEFT_MOTOR_PIN1, LOW);
  digitalWrite(LEFT_MOTOR_PIN2, LOW);
  digitalWrite(RIGHT_MOTOR_PIN1, LOW);
  digitalWrite(RIGHT_MOTOR_PIN2, LOW);
  
  analogWrite(LEFT_MOTOR_PWM, 0);
  analogWrite(RIGHT_MOTOR_PWM, 0);
}

// 速度常數定義
const int SPEED_STOP = 0;
const int SPEED_LOW = 100;
const int SPEED_MEDIUM = 180;
const int SPEED_HIGH = 255;
*/

// ========== 輔助函數 (可選) ==========

/*
 * 使用範例:
 * 
 * 1. 基本讀取:
 *    QRE_AllSensors sensors = getAllSensors();
 *    float voltage = sensors.getVoltage(0);
 * 
 * 2. 邊緣檢測:
 *    if (sensors.isEdgeDetected()) {
 *      String direction = sensors.getEdgeDirection();
 *      // 執行避險動作
 *    }
 * 
 * 3. 戰術決策:
 *    SumoAction action = decideSumoAction(sensors);
 *    executeSumoAction(action, sensors);
 * 
 * 4. 高速控制循環:
 *    int16_t raw_values[4];
 *    getAllSensorsRaw(raw_values);
 *    // 直接使用原始值進行快速判斷
 * 
 * 5. OLED 顯示功能:
 *    - 啟動時自動顯示歡迎畫面
 *    - 系統狀態頁面：核心頻率、感測器數值
 *    - 戰術狀態頁面：當前動作、危險等級、方向
 *    - 自動在正常和緊急模式間切換顯示
 * 
 * 設置步驟:
 * 1. 安裝 Arduino IDE 庫:
 *    - Adafruit ADS1X15
 *    - Adafruit GFX Library
 *    - Adafruit SSD1306
 * 2. 連接硬體如上述線路圖
 * 3. 上傳程式到 Raspberry Pi Pico
 * 4. 打開串口監視器查看系統狀態
 * 5. OLED 將自動顯示啟動信息和運行狀態
 */
