wedsamuel1230/CTEA-BottleSumo/software/gui/viewer.py

"""Bottle Sumo Real-Time TCP viewer.

This script connects to the Bottle Sumo robot's TCP streaming server (default port 4242),
parses the JSON telemetry stream, and visualises the data in a Tkinter GUI.

The robot firmware periodically sends newline-delimited JSON objects that contain
sensor readings, robot state, and system information. The GUI displays the data and
keeps updating as new packets arrive.
"""
from __future__ import annotations

import json
import queue
import socket
import threading
import time
import tkinter as tk
from dataclasses import dataclass, field
from tkinter import messagebox, ttk
from typing import Any, Dict, Optional

# Default connection settings that match the firmware (`TCP_SERVER_PORT = 4242`).
DEFAULT_HOST = "192.168.42.1"
DEFAULT_PORT = 4242

# Socket settings.
SOCKET_RECV_BYTES = 4096
SOCKET_TIMEOUT = 1.0  # seconds


@dataclass
class TelemetryPacket:
    """Container for a parsed telemetry JSON document."""

    timestamp: int = 0
    sensors_raw: list[int] = field(default_factory=list)
    sensors_voltage: list[float] = field(default_factory=list)
    tof_distances: list[int] = field(default_factory=list)
    tof_valid: list[bool] = field(default_factory=list)
    tof_status: list[int] = field(default_factory=list)
    tof_object_direction: str = ""
    robot_state: Dict[str, Any] = field(default_factory=dict)
    system_info: Dict[str, Any] = field(default_factory=dict)
    ir_edge_thresholds: list[float] = field(default_factory=lambda: [2.5, 2.5, 2.5, 2.5])  # Default IR edge detection thresholds (volts) for each sensor
    tof_detection_threshold: int = 1600  # Default ToF detection threshold (mm)
    test_mode: str = "AUTO"  # Current test mode
    motor_left: int = 0  # Left motor PWM
    motor_right: int = 0  # Right motor PWM
    motor_estop: bool = False  # Emergency stop status

    @classmethod
    def from_json(cls, payload: Dict[str, Any]) -> "TelemetryPacket":
        """Create a packet from the decoded JSON dictionary."""
        # IR sensors (legacy name 'sensors' or new name 'irsensors')
        sensors = payload.get("irsensors", payload.get("sensors", {}))
        
        # ToF sensors - support both 'tof' (new firmware) and 'tofsensors' (legacy)
        tofsensors = payload.get("tof", payload.get("tofsensors", {}))
        
        # Map field names: firmware uses 'distance_mm' and 'direction', viewer expects 'distances' and 'object_direction'
        distances = tofsensors.get("distance_mm", tofsensors.get("distances", []))
        direction = tofsensors.get("direction", tofsensors.get("object_direction", ""))
        
        # Handle edge_threshold - can be single value (legacy) or list (new firmware)
        edge_threshold_data = sensors.get("edge_threshold", [2.5, 2.5, 2.5, 2.5])
        if isinstance(edge_threshold_data, list):
            ir_edge_thresholds = [float(t) for t in edge_threshold_data]
        else:
            # Legacy single threshold - replicate for all 4 sensors
            single_threshold = float(edge_threshold_data)
            ir_edge_thresholds = [single_threshold] * 4
        
        # Parse test mode and motor status
        test_mode = payload.get("test_mode", "AUTO")
        motors = payload.get("motors", {})
        motor_left = motors.get("left", 0)
        motor_right = motors.get("right", 0)
        motor_estop = motors.get("estop", False)

        return cls(
            timestamp=payload.get("timestamp", 0),
            sensors_raw=list(sensors.get("raw", [])),
            sensors_voltage=list(sensors.get("voltage", [])),
            tof_distances=list(distances),
            tof_valid=list(tofsensors.get("valid", [])),
            tof_status=list(tofsensors.get("status", [])),
            tof_object_direction=direction,
            robot_state=dict(payload.get("robot_state", {})),
            system_info=dict(payload.get("system_info", {})),
            ir_edge_thresholds=ir_edge_thresholds,
            tof_detection_threshold=int(tofsensors.get("detection_threshold", 1600)),
            test_mode=test_mode,
            motor_left=motor_left,
            motor_right=motor_right,
            motor_estop=motor_estop,
        )


class TelemetryReader(threading.Thread):
    """Background thread that maintains the TCP connection and feeds packets into a queue."""

    def __init__(
        self,
        host: str,
        port: int,
        output_queue: "queue.Queue[TelemetryPacket | Exception]",
    ) -> None:
        super().__init__(name="TelemetryReader", daemon=True)
        self._host = host
        self._port = port
        self._output_queue = output_queue
        self._sock: Optional[socket.socket] = None
        self._stop_event = threading.Event()
        self._buffer = ""

    def stop(self) -> None:
        self._stop_event.set()
        if self._sock:
            try:
                self._sock.shutdown(socket.SHUT_RDWR)
            except OSError:
                pass
            finally:
                try:
                    self._sock.close()
                except OSError:
                    pass

    def run(self) -> None:  # pragma: no cover - thread loop is hard to unit-test here
        try:
            self._sock = socket.create_connection((self._host, self._port), timeout=SOCKET_TIMEOUT)
            self._sock.settimeout(SOCKET_TIMEOUT)
        except OSError as exc:
            self._output_queue.put(exc)
            return

        while not self._stop_event.is_set():
            try:
                chunk = self._sock.recv(SOCKET_RECV_BYTES)
            except socket.timeout:
                continue  # allow stop checks
            except OSError as exc:
                self._output_queue.put(exc)
                break

            if not chunk:
                # Remote closed the connection
                self._output_queue.put(ConnectionError("Connection closed by remote host."))
                break

            self._buffer += chunk.decode("utf-8", errors="ignore")
            *complete_messages, self._buffer = self._buffer.split("\n")

            for message in complete_messages:
                message = message.strip()
                if not message:
                    continue
                try:
                    payload = json.loads(message)
                    
                    # Check if this is an acknowledgment message (not telemetry)
                    if "ack" in payload or "error" in payload:
                        # Pass acknowledgment/error to GUI (wrapped in dict for identification)
                        self._output_queue.put({"_type": "ack", "payload": payload})
                    else:
                        # Regular telemetry packet
                        packet = TelemetryPacket.from_json(payload)
                        self._output_queue.put(packet)
                except json.JSONDecodeError as exc:
                    self._output_queue.put(exc)

        self.stop()


class BottleSumoViewer(tk.Tk):
    """Tkinter application that visualises telemetry updates."""

    def __init__(self) -> None:
        super().__init__()
        self.title("Bottle Sumo Real-Time Viewer")
        self.geometry("900x950")  # Wider for two-column layout
        self.minsize(850, 900)

        self._reader_thread: Optional[TelemetryReader] = None
        self._queue: "queue.Queue[TelemetryPacket | Exception]" = queue.Queue()

        # Motor control variables
        self.motor1_var = tk.IntVar(value=0)  # Motor 1 PWM (-100 to +100)
        self.motor2_var = tk.IntVar(value=0)  # Motor 2 PWM (-100 to +100)
        self.motor_enabled_var = tk.BooleanVar(value=False)  # Enable/disable transmission
        
        # Test mode variables
        self.test_mode_var = tk.StringVar(value="AUTO")  # Current test mode

        # Variables for window dragging
        self._drag_start_x = 0
        self._drag_start_y = 0
        
        # Configurable thresholds (one per sensor, user can adjust via UI)
        self.ir_threshold_configs = [tk.DoubleVar(value=2.5) for _ in range(4)]  # Default 2.5V for each sensor
        
        # Store last telemetry packet for redrawing when threshold changes
        self._last_packet: Optional[TelemetryPacket] = None
        
        # Flag to display firmware threshold only initially from telemetry
        self.initial_threshold_displayed = False
        
        # Configure custom progress bar styles for color coding
        self._setup_progress_bar_styles()
        
        # Define unique colors for each IR sensor's threshold bar
        self.sensor_colors = ['#FF6B6B', '#4ECDC4', '#45B7D1', '#96CEB4']  # Red, Teal, Blue, Green

        self._build_ui()
        self._setup_window_drag()
        self._schedule_queue_processing()

    # ------------------------------------------------------------------
    # UI construction helpers
    # ------------------------------------------------------------------
    def _setup_progress_bar_styles(self) -> None:
        """Configure ttk.Style for color-coded progress bars (green/yellow/red zones)."""
        style = ttk.Style()
        
        # IR Sensor styles (voltage-based)
        style.configure('IR.green.Horizontal.TProgressbar', troughcolor='#e0e0e0', background='#4CAF50')  # Green
        style.configure('IR.yellow.Horizontal.TProgressbar', troughcolor='#e0e0e0', background='#FFC107')  # Yellow
        style.configure('IR.red.Horizontal.TProgressbar', troughcolor='#e0e0e0', background='#F44336')  # Red
        
        # ToF Sensor styles (distance-based, inverse logic: closer = more danger)
        style.configure('ToF.green.Horizontal.TProgressbar', troughcolor='#e0e0e0', background='#4CAF50')  # Green
        style.configure('ToF.yellow.Horizontal.TProgressbar', troughcolor='#e0e0e0', background='#FFC107')  # Yellow
        style.configure('ToF.red.Horizontal.TProgressbar', troughcolor='#e0e0e0', background='#F44336')  # Red
    
    def _build_ui(self) -> None:
        root = ttk.Frame(self, padding=12)
        root.grid(row=0, column=0, sticky="nsew")
        self.columnconfigure(0, weight=1)
        self.rowconfigure(0, weight=1)
        
        # Configure root grid for two-column layout
        root.columnconfigure(0, weight=1)
        root.columnconfigure(1, weight=1)

        # Connection controls (LEFT SIDE) -------------------------------------
        connection_frame = ttk.LabelFrame(root, text="Connection", padding=8)
        connection_frame.grid(row=0, column=0, sticky="ew", padx=(0, 5))
        connection_frame.columnconfigure(1, weight=1)

        ttk.Label(connection_frame, text="Host:").grid(row=0, column=0, sticky="w")
        self.host_var = tk.StringVar(value=DEFAULT_HOST)
        ttk.Entry(connection_frame, textvariable=self.host_var).grid(row=0, column=1, sticky="ew", padx=4)

        ttk.Label(connection_frame, text="Port:").grid(row=0, column=2, sticky="w")
        self.port_var = tk.IntVar(value=DEFAULT_PORT)
        ttk.Entry(connection_frame, textvariable=self.port_var, width=8).grid(row=0, column=3, sticky="ew", padx=4)

        self.connect_button = ttk.Button(connection_frame, text="Connect", command=self._toggle_connection)
        self.connect_button.grid(row=0, column=4, padx=(8, 0))

        # Test Mode controls (RIGHT SIDE) -------------------------------------
        test_mode_frame = ttk.LabelFrame(root, text="Test Mode", padding=8)
        test_mode_frame.grid(row=0, column=1, sticky="ew", padx=(5, 0))
        test_mode_frame.columnconfigure(1, weight=1)

        ttk.Label(test_mode_frame, text="Mode:").grid(row=0, column=0, sticky="w", padx=5)
        self.mode_selector = ttk.Combobox(test_mode_frame, textvariable=self.test_mode_var, 
                                         values=["AUTO", "TEST_MOTOR", "TEST_SENSOR", "CALIBRATE_IR", "CALIBRATE_TOF"],
                                         state="readonly", width=15)
        self.mode_selector.grid(row=0, column=1, sticky="ew", padx=5)
        self.mode_selector.bind("<<ComboboxSelected>>", self._on_mode_change)

        self.mode_apply_button = ttk.Button(test_mode_frame, text="Apply Mode", command=self._apply_test_mode)
        self.mode_apply_button.grid(row=0, column=2, padx=5)
        
        self.mode_status_var = tk.StringVar(value="Current: AUTO")
        ttk.Label(test_mode_frame, textvariable=self.mode_status_var).grid(row=1, column=0, columnspan=3, sticky="w", padx=5, pady=(5, 0))

        # Sensor data (LEFT SIDE) ---------------------------------------------
        sensors_frame = ttk.LabelFrame(root, text="Sensors", padding=8)
        sensors_frame.grid(row=1, column=0, sticky="nsew", pady=(10, 0), padx=(0, 5))
        sensors_frame.columnconfigure(1, weight=1)
        sensors_frame.columnconfigure(3, weight=1)

        ttk.Label(sensors_frame, text="Index").grid(row=0, column=0, padx=4, sticky="w")
        ttk.Label(sensors_frame, text="Raw").grid(row=0, column=1, padx=4, sticky="w")
        ttk.Label(sensors_frame, text="Voltage (V)").grid(row=0, column=2, padx=4, sticky="w")
        ttk.Label(sensors_frame, text="Level").grid(row=0, column=3, padx=4, sticky="w")

        self.sensor_raw_labels: list[tk.StringVar] = []
        self.sensor_voltage_labels: list[tk.StringVar] = []
        self.sensor_voltage_bars: list[ttk.Progressbar] = []
        self.sensor_threshold_markers: list[tk.Canvas] = []  # Canvas overlays for threshold lines
        
        for idx in range(4):
            ttk.Label(sensors_frame, text=f"Sensor {idx}").grid(row=idx + 1, column=0, sticky="w", padx=5)
            raw_var = tk.StringVar(value="-")
            volt_var = tk.StringVar(value="-")
            ttk.Label(sensors_frame, textvariable=raw_var).grid(row=idx + 1, column=1, sticky="w", padx=5)
            ttk.Label(sensors_frame, textvariable=volt_var).grid(row=idx + 1, column=2, sticky="w", padx=5)
            
            # Add Canvas for voltage bar visualization with threshold marker overlay
            # Canvas draws both the voltage-filled bar AND the draggable threshold line
            bar_container = tk.Frame(sensors_frame, relief=tk.SUNKEN, borderwidth=1)
            bar_container.grid(row=idx + 1, column=3, sticky="ew", padx=5)
            
            # Canvas shows gray background (trough), voltage bar (colored fill), and threshold line
            voltage_canvas = tk.Canvas(bar_container, width=150, height=20, highlightthickness=0, bg='#e0e0e0')
            voltage_canvas.pack(fill='both', expand=True)
            
            # Bind mouse events for draggable threshold marker
            voltage_canvas.bind("<Enter>", self._on_threshold_marker_enter)
            voltage_canvas.bind("<Leave>", self._on_threshold_marker_leave)
            voltage_canvas.bind("<Button-1>", self._on_threshold_drag_start)
            voltage_canvas.bind("<B1-Motion>", self._on_threshold_drag_motion)
            voltage_canvas.bind("<ButtonRelease-1>", self._on_threshold_drag_end)
            
            self.sensor_raw_labels.append(raw_var)
            self.sensor_voltage_labels.append(volt_var)
            self.sensor_voltage_bars.append(voltage_canvas)  # Now stores Canvas instead of Progressbar
            self.sensor_threshold_markers.append(voltage_canvas)  # Same Canvas for both bar and threshold

        # Motor Control (RIGHT SIDE) ------------------------------------------
        motor_frame = ttk.LabelFrame(root, text="Motor Control", padding=8)
        motor_frame.grid(row=1, column=1, sticky="nsew", pady=(10, 0), padx=(5, 0))
        motor_frame.columnconfigure(1, weight=1)

        # Motor 1 slider
        ttk.Label(motor_frame, text="Motor 1 PWM:").grid(row=0, column=0, sticky="w", padx=5, pady=5)
        self.motor1_scale = tk.Scale(motor_frame, from_=-100, to=100, orient=tk.HORIZONTAL, variable=self.motor1_var, length=200, resolution=5, command=self._on_motor_slider_change, showvalue=0)
        self.motor1_scale.grid(row=0, column=1, sticky="ew", padx=5)
        self.motor1_value_label = ttk.Label(motor_frame, textvariable=self.motor1_var)
        self.motor1_value_label.grid(row=0, column=2, sticky="w", padx=5)

        # Motor 2 slider
        ttk.Label(motor_frame, text="Motor 2 PWM:").grid(row=1, column=0, sticky="w", padx=5, pady=5)
        self.motor2_scale = tk.Scale(motor_frame, from_=-100, to=100, orient=tk.HORIZONTAL, variable=self.motor2_var, length=200, resolution=5, command=self._on_motor_slider_change, showvalue=0)
        self.motor2_scale.grid(row=1, column=1, sticky="ew", padx=5)
        self.motor2_value_label = ttk.Label(motor_frame, textvariable=self.motor2_var)
        self.motor2_value_label.grid(row=1, column=2, sticky="w", padx=5)

        # Enable transmission checkbox and status
        self.motor_enable_check = ttk.Checkbutton(motor_frame, text="Enable Transmission", variable=self.motor_enabled_var)
        self.motor_enable_check.grid(row=2, column=0, columnspan=2, sticky="w", padx=5, pady=5)
        
        self.motor_status_var = tk.StringVar(value="Idle")
        ttk.Label(motor_frame, text="Status:").grid(row=2, column=2, sticky="e", padx=5)

        # Threshold Configuration (FULL WIDTH) ----------------------------
        threshold_frame = ttk.LabelFrame(root, text="Threshold Configuration", padding=8)
        threshold_frame.grid(row=2, column=0, columnspan=2, sticky="ew", pady=(10, 0))
        threshold_frame.columnconfigure(1, weight=1)
        
        # IR Edge Thresholds (one per sensor, user configurable)
        self.threshold_spinboxes = []
        self.threshold_apply_buttons = []
        for idx in range(4):
            ttk.Label(threshold_frame, text=f"IR Sensor {idx} Threshold (V):").grid(row=idx, column=0, sticky="w", padx=5)
            spinbox = ttk.Spinbox(threshold_frame, from_=0.0, to=4.096, increment=0.1, 
                                  textvariable=self.ir_threshold_configs[idx], width=8)
            spinbox.grid(row=idx, column=1, sticky="w", padx=5)
            apply_button = ttk.Button(threshold_frame, text="Apply", command=lambda i=idx: self._apply_single_threshold(i))
            apply_button.grid(row=idx, column=2, sticky="w", padx=5)
            self.threshold_spinboxes.append(spinbox)
            self.threshold_apply_buttons.append(apply_button)
        
        # Display firmware's threshold values (read-only)
        ttk.Label(threshold_frame, text="Firmware IR Thresholds:").grid(row=4, column=0, sticky="w", padx=5)
        self.firmware_ir_threshold_var = tk.StringVar(value="-")
        ttk.Label(threshold_frame, textvariable=self.firmware_ir_threshold_var).grid(row=4, column=1, columnspan=2, sticky="w", padx=5)
        
        # ToF Sensors data (FULL WIDTH) ---------------------------------------
        tof_frame = ttk.LabelFrame(root, text="ToF Sensors (VL53L0X)", padding=8)
        tof_frame.grid(row=3, column=0, columnspan=2, sticky="ew", pady=(10, 0))
        tof_frame.columnconfigure(3, weight=1)  # Make proximity bar column expandable

        ttk.Label(tof_frame, text="Direction").grid(row=0, column=0, padx=4, sticky="w")
        ttk.Label(tof_frame, text="Distance (mm)").grid(row=0, column=1, padx=4, sticky="w")
        ttk.Label(tof_frame, text="Status").grid(row=0, column=2, padx=4, sticky="w")
        ttk.Label(tof_frame, text="Proximity").grid(row=0, column=3, padx=4, sticky="w")

        self.tof_distance_labels: list[tk.StringVar] = []
        self.tof_status_labels: list[tk.StringVar] = []
        self.tof_proximity_bars: list[ttk.Progressbar] = []
        tof_directions = ["Right", "Front", "Left"]
        
        for idx, direction in enumerate(tof_directions):
            ttk.Label(tof_frame, text=direction).grid(row=idx + 1, column=0, sticky="w", padx=5)
            distance_var = tk.StringVar(value="-")
            status_var = tk.StringVar(value="-")
            ttk.Label(tof_frame, textvariable=distance_var).grid(row=idx + 1, column=1, sticky="w", padx=5)
            ttk.Label(tof_frame, textvariable=status_var).grid(row=idx + 1, column=2, sticky="w", padx=5)
            
            # Add progress bar for proximity visualization (0-2000mm range, inverse display)
            # Bar fills MORE as object gets CLOSER (provides intuitive threat/proximity indication)
            proximity_bar = ttk.Progressbar(tof_frame, mode='determinate', length=150, maximum=2000)
            proximity_bar.grid(row=idx + 1, column=3, sticky="ew", padx=5)
            
            self.tof_distance_labels.append(distance_var)
            self.tof_status_labels.append(status_var)
            self.tof_proximity_bars.append(proximity_bar)

        self.tof_object_direction_var = tk.StringVar(value="-")
        ttk.Label(tof_frame, text="Object Direction:").grid(row=4, column=0, sticky="w")
        ttk.Label(tof_frame, textvariable=self.tof_object_direction_var).grid(row=4, column=1, columnspan=2, sticky="w")

        # Robot state (FULL WIDTH) --------------------------------------------
        state_frame = ttk.LabelFrame(root, text="Robot State", padding=8)
        state_frame.grid(row=4, column=0, columnspan=2, sticky="ew", pady=(10, 0))
        state_frame.columnconfigure(1, weight=1)

        self.action_var = tk.StringVar(value="-")
        ttk.Label(state_frame, text="Action:").grid(row=0, column=0, sticky="w")
        ttk.Label(state_frame, textvariable=self.action_var).grid(row=0, column=1, sticky="w")

        self.edge_detected_var = tk.StringVar(value="-")
        ttk.Label(state_frame, text="Edge Detected:").grid(row=1, column=0, sticky="w")
        ttk.Label(state_frame, textvariable=self.edge_detected_var).grid(row=1, column=1, sticky="w")

        self.edge_direction_var = tk.StringVar(value="-")
        ttk.Label(state_frame, text="Edge Direction:").grid(row=2, column=0, sticky="w")
        ttk.Label(state_frame, textvariable=self.edge_direction_var).grid(row=2, column=1, sticky="w")

        self.danger_level_var = tk.StringVar(value="-")
        ttk.Label(state_frame, text="Danger Level:").grid(row=3, column=0, sticky="w")
        ttk.Label(state_frame, textvariable=self.danger_level_var).grid(row=3, column=1, sticky="w")

        # System info (FULL WIDTH) --------------------------------------------
        system_frame = ttk.LabelFrame(root, text="System Info", padding=8)
        system_frame.grid(row=5, column=0, columnspan=2, sticky="ew", pady=(10, 0))
        system_frame.columnconfigure(1, weight=1)

        self.timestamp_var = tk.StringVar(value="-")
        ttk.Label(system_frame, text="Timestamp (ms):").grid(row=0, column=0, sticky="w")
        ttk.Label(system_frame, textvariable=self.timestamp_var).grid(row=0, column=1, sticky="w")

        self.core0_freq_var = tk.StringVar(value="-")
        ttk.Label(system_frame, text="Core0 freq (Hz):").grid(row=1, column=0, sticky="w")
        ttk.Label(system_frame, textvariable=self.core0_freq_var).grid(row=1, column=1, sticky="w")

        self.core1_freq_var = tk.StringVar(value="-")
        ttk.Label(system_frame, text="Core1 freq (Hz):").grid(row=2, column=0, sticky="w")
        ttk.Label(system_frame, textvariable=self.core1_freq_var).grid(row=2, column=1, sticky="w")

        self.wifi_rssi_var = tk.StringVar(value="-")
        ttk.Label(system_frame, text="WiFi RSSI (dBm):").grid(row=3, column=0, sticky="w")
        ttk.Label(system_frame, textvariable=self.wifi_rssi_var).grid(row=3, column=1, sticky="w")

        self.free_heap_var = tk.StringVar(value="-")
        ttk.Label(system_frame, text="Free heap (bytes):").grid(row=4, column=0, sticky="w")
        ttk.Label(system_frame, textvariable=self.free_heap_var).grid(row=4, column=1, sticky="w")

        # Status bar (FULL WIDTH) ---------------------------------------------
        self.status_var = tk.StringVar(value="Idle")
        status_bar = ttk.Label(root, textvariable=self.status_var, relief=tk.SUNKEN, anchor="w")
        status_bar.grid(row=6, column=0, columnspan=2, sticky="ew", pady=(10, 0))

        root.rowconfigure(1, weight=1)  # Make sensors row expandable
        
        # Initialize threshold markers after UI is built
        self._update_threshold_markers()

    def _apply_threshold_changes(self) -> None:
        """Apply threshold changes: update GUI markers and send commands to firmware.
        
        Sends TCP commands to the Arduino firmware to update the runtime threshold values.
        The firmware will acknowledge the commands and immediately start using the new thresholds.
        """
        # Update GUI threshold markers
        self._update_threshold_markers()
        
        # Check if connected before sending commands
        if not self._reader_thread or not self._reader_thread.is_alive():
            self.status_var.set("⚠️ Not connected. Connect first to apply thresholds.")
            return
        
        # Send threshold commands for each sensor
        thresholds = [round(config.get(), 2) for config in self.ir_threshold_configs]
        self._send_threshold_commands(thresholds)
    
    def _apply_single_threshold(self, sensor_idx: int) -> None:
        """Apply threshold change for a single sensor.
        
        Args:
            sensor_idx: Index of the sensor (0-3) to update
        """
        # Update GUI threshold markers
        self._update_threshold_markers()
        
        # Check if connected before sending commands
        if not self._reader_thread or not self._reader_thread.is_alive():
            self.status_var.set("⚠️ Not connected. Connect first to apply thresholds.")
            return
        
        # Send threshold command for single sensor
        threshold_value = round(self.ir_threshold_configs[sensor_idx].get(), 2)
        self._send_single_threshold_command(sensor_idx, threshold_value)
    
    def _send_threshold_commands(self, thresholds: list[float]) -> None:
        """Send threshold configuration commands to Arduino firmware via TCP.
        
        Args:
            thresholds: List of threshold voltage values (0.1 - 4.0V) for each sensor
        """
        try:
            # Get socket from reader thread
            if not hasattr(self._reader_thread, '_sock') or not self._reader_thread._sock:
                self.status_var.set("❌ Connection socket not available")
                return
            
            sock = self._reader_thread._sock
            
            # Send command for each sensor
            for idx, value in enumerate(thresholds):
                # Build JSON command: {"cmd":"set_threshold","sensor":0,"value":2.5}
                command = {"cmd":"set_threshold","sensor":idx,"value":value}
                command_str = json.dumps(command) + "\n"
                sock.sendall(command_str.encode('utf-8'))
                print(f"[TCP] Sent command for sensor {idx}: {command_str.strip()}")
            
            self.status_var.set(f"📤 Sent threshold commands for {len(thresholds)} sensors (awaiting acks...)")
            
        except Exception as e:
            self.status_var.set(f"❌ Failed to send commands: {e}")
            print(f"[TCP] Error sending commands: {e}")

    def _send_single_threshold_command(self, sensor_idx: int, threshold_value: float) -> None:
        """Send threshold configuration command for a single sensor to Arduino firmware via TCP.
        
        Args:
            sensor_idx: Index of the sensor (0-3)
            threshold_value: Threshold voltage value (0.1 - 4.0V)
        """
        try:
            # Get socket from reader thread
            if not hasattr(self._reader_thread, '_sock') or not self._reader_thread._sock:
                self.status_var.set("❌ Connection socket not available")
                return
            
            sock = self._reader_thread._sock
            
            # Build JSON command: {"cmd":"set_threshold","sensor":0,"value":2.5}
            command = {"cmd":"set_threshold","sensor":sensor_idx,"value":threshold_value}
            command_str = json.dumps(command) + "\n"
            sock.sendall(command_str.encode('utf-8'))
            print(f"[TCP] Sent command for sensor {sensor_idx}: {command_str.strip()}")
            
            self.status_var.set(f"📤 Sent threshold command for sensor {sensor_idx} (awaiting ack...)")
            
        except Exception as e:
            self.status_var.set(f"❌ Failed to send command: {e}")
            print(f"[TCP] Error sending command: {e}")

    def _draw_voltage_bar(self, sensor_idx: int, voltage: float, fill_color: str) -> None:
        """Draw voltage bar on Canvas with sensor-specific threshold line overlay.
        
        Args:
            sensor_idx: Index of sensor (0-3)
            voltage: Voltage value (0-4.096V)
            fill_color: Bar fill color (hex string like '#4CAF50')
        """
        canvas = self.sensor_voltage_bars[sensor_idx]
        canvas.delete('all')  # Clear previous drawing
        
        canvas_width = canvas.winfo_width() if canvas.winfo_width() > 1 else 150
        canvas_height = canvas.winfo_height() if canvas.winfo_height() > 1 else 20
        
        # Calculate fill width based on voltage (0-4.096V range)
        fill_width = (voltage / 4.096) * canvas_width
        
        # Draw filled rectangle for voltage level
        if fill_width > 0:
            canvas.create_rectangle(0, 0, fill_width, canvas_height, fill=fill_color, outline='')
        
        # Draw sensor-specific threshold line on top
        threshold_voltage = self.ir_threshold_configs[sensor_idx].get()
        line_x = (threshold_voltage / 4.096) * canvas_width
        
        # Use sensor-specific color for threshold line
        threshold_color = self.sensor_colors[sensor_idx]
        
        # White outline for visibility
        canvas.create_line(line_x, 0, line_x, canvas_height, fill='#FFFFFF', width=4, tags='threshold_outline')
        # Sensor-specific color line on top
        canvas.create_line(line_x, 0, line_x, canvas_height, fill=threshold_color, width=2, tags='threshold')

    def _update_threshold_markers(self) -> None:
        """Update threshold line positions on IR sensor Canvas displays.
        
        Note: Since Canvas now draws both voltage bar AND threshold line,
        we need to redraw everything when any threshold changes.
        """
        # Trigger a full redraw of all voltage bars with current values
        # This will redraw both the bar and the new threshold positions
        if hasattr(self, '_last_packet') and self._last_packet:
            # Re-process last packet to redraw bars with new thresholds
            for idx in range(4):
                volt_value = self._last_packet.sensors_voltage[idx] if idx < len(self._last_packet.sensors_voltage) else None
                if isinstance(volt_value, (float, int)):
                    bar_value = max(0.0, min(4.096, float(volt_value)))
                    # Use sensor-specific color
                    fill_color = self.sensor_colors[idx]
                    self._draw_voltage_bar(idx, bar_value, fill_color)
                else:
                    self._draw_voltage_bar(idx, 0.0, self.sensor_colors[idx])
        else:
            # No data yet, just draw threshold lines on empty bars
            for idx in range(4):
                self._draw_voltage_bar(idx, 0.0, self.sensor_colors[idx])
    
    def _on_threshold_marker_enter(self, event) -> None:
        """Change cursor to horizontal resize when hovering over threshold marker."""
        event.widget.config(cursor="sb_h_double_arrow")
    
    def _on_threshold_marker_leave(self, event) -> None:
        """Restore default cursor when leaving threshold marker."""
        event.widget.config(cursor="")
    
    def _on_threshold_drag_start(self, event) -> None:
        """Start dragging threshold marker."""
        # Store initial drag position (optional, for future enhancements)
        self._dragging = True
        return "break"  # Prevent event from bubbling to window drag handler
    
    def _on_threshold_drag_motion(self, event) -> None:
        """Update threshold value for the specific sensor while dragging marker."""
        if not hasattr(self, '_dragging') or not self._dragging:
            return "break"
        
        # Identify which sensor's canvas is being dragged
        sensor_idx = None
        for idx, canvas in enumerate(self.sensor_threshold_markers):
            if canvas == event.widget:
                sensor_idx = idx
                break
        
        if sensor_idx is None:
            return "break"
        
        # Get canvas width (use actual width if rendered, fallback to 150px)
        canvas = event.widget
        canvas_width = canvas.winfo_width() if canvas.winfo_width() > 1 else 150
        
        # Convert mouse X position to voltage (0-4.096V range)
        voltage = (event.x / canvas_width) * 4.096
        
        # Clamp voltage to valid range
        voltage = max(0.0, min(4.096, voltage))
        
        # Quantize to 0.1V steps for discrete movement
        voltage = round(voltage * 10) / 10
        
        # Update the specific sensor's threshold config
        self.ir_threshold_configs[sensor_idx].set(voltage)
        
        # Redraw all threshold markers immediately
        self._update_threshold_markers()
        
        return "break"  # Prevent event from bubbling to window drag handler
    
    def _on_threshold_drag_end(self, event) -> None:
        """Finish dragging threshold marker."""
        self._dragging = False
        return "break"  # Prevent event from bubbling to window drag handler

    def _setup_window_drag(self) -> None:
        """Enable dragging the window by clicking and dragging on the title bar or background."""
        # Bind to the main window
        self.bind("<Button-1>", self._start_drag)
        self.bind("<B1-Motion>", self._on_drag)
        
    def _start_drag(self, event) -> None:
        """Record the starting position for window drag."""
        # Ignore events from interactive widgets (Scale, Entry, Scrollbar, Button, Checkbutton, etc.)
        widget_class = event.widget.winfo_class()
        if widget_class in ('Scale', 'Entry', 'TEntry', 'Scrollbar', 'TScrollbar', 'Button', 'TButton', 'Checkbutton', 'TCheckbutton', 'Spinbox', 'TSpinbox'):
            return
        
        self._drag_start_x = event.x
        self._drag_start_y = event.y
        
    def _on_drag(self, event) -> None:
        """Move the window as the mouse is dragged."""
        # Ignore events from interactive widgets
        widget_class = event.widget.winfo_class()
        if widget_class in ('Scale', 'Entry', 'TEntry', 'Scrollbar', 'TScrollbar', 'Button', 'TButton', 'Checkbutton', 'TCheckbutton', 'Spinbox', 'TSpinbox'):
            return
        
        x = self.winfo_x() + (event.x - self._drag_start_x)
        y = self.winfo_y() + (event.y - self._drag_start_y)
        self.geometry(f"+{x}+{y}")

    # ------------------------------------------------------------------
    # Connection handling
    # ------------------------------------------------------------------
    def _toggle_connection(self) -> None:
        if self._reader_thread and self._reader_thread.is_alive():
            self._disconnect()
        else:
            self._connect()
    
    def _on_mode_change(self, event=None) -> None:
        """Handle test mode combobox selection change."""
        pass  # Just update the UI variable, actual change happens on Apply button
    
    def _apply_test_mode(self) -> None:
        """Apply the selected test mode by sending SET_MODE command to Arduino."""
        if not self._reader_thread or not self._reader_thread.is_alive():
            messagebox.showwarning("Not Connected", "Please connect to the robot first.")
            return
        
        mode = self.test_mode_var.get()
        try:
            # Send SET_MODE command to Arduino
            sock = socket.socket(socket.AF_INET, socket.SOCK_STREAM)
            sock.settimeout(2.0)
            sock.connect((self.host_var.get(), self.port_var.get()))
            command = f"SET_MODE {mode}\n"
            sock.sendall(command.encode('utf-8'))
            
            # Wait for acknowledgment
            response = sock.recv(256).decode('utf-8', errors='ignore')
            sock.close()
            
            if "ack" in response.lower():
                self.mode_status_var.set(f"Current: {mode}")
                self.status_var.set(f"Test mode changed to {mode}")
            else:
                self.status_var.set(f"Mode change failed: {response}")
        except Exception as e:
            messagebox.showerror("Error", f"Failed to apply test mode:\n{e}")
            self.status_var.set(f"Mode change error: {e}")

    # ------------------------------------------------------------------
    # Connection handling (continued)
    # ------------------------------------------------------------------
    def _toggle_connection(self) -> None:
        if self._reader_thread and self._reader_thread.is_alive():
            self._disconnect()
        else:
            self._connect()

    def _connect(self) -> None:
        host = self.host_var.get().strip() or DEFAULT_HOST
        try:
            port = int(self.port_var.get())
        except (tk.TclError, ValueError):
            messagebox.showerror("Invalid Port", "Please enter a valid integer port number.")
            return

        self.status_var.set(f"Connecting to {host}:{port}…")
        self.connect_button.config(text="Disconnect")

        self._reader_thread = TelemetryReader(host, port, self._queue)
        self._reader_thread.start()

    def _disconnect(self) -> None:
        if self._reader_thread:
            self.status_var.set("Disconnecting…")
            self._reader_thread.stop()
            self._reader_thread.join(timeout=2.0)
            self._reader_thread = None
        self.connect_button.config(text="Connect")
        self.status_var.set("Disconnected")

    # ------------------------------------------------------------------
    # Motor control
    # ------------------------------------------------------------------
    def _on_motor_slider_change(self, value=None) -> None:
        """Called when motor sliders are adjusted. Sends motor command if enabled."""
        # Only send if transmission is enabled and connected
        if not self.motor_enabled_var.get():
            return
        
        if not self._reader_thread or not self._reader_thread.is_alive():
            self.motor_status_var.set("⚠️ Not connected")
            return
        
        self._send_motor_command()
    
    def _send_motor_command(self) -> None:
        """Send motor control command via TEST_MOTOR command to Arduino firmware."""
        try:
            motor1_value = self.motor1_var.get()
            motor2_value = self.motor2_var.get()
            
            # Create a new socket connection for sending commands
            sock = socket.socket(socket.AF_INET, socket.SOCK_STREAM)
            sock.settimeout(1.0)
            sock.connect((self.host_var.get(), self.port_var.get()))
            
            # Send TEST_MOTOR command (format: TEST_MOTOR <left> <right>)
            command = f"TEST_MOTOR {motor1_value} {motor2_value}\n"
            sock.sendall(command.encode('utf-8'))
            
            # Wait for acknowledgment
            response = sock.recv(256).decode('utf-8', errors='ignore')
            sock.close()
            
            if "OK" in response:
                self.motor_status_var.set(f"✓ M1:{motor1_value} M2:{motor2_value}")
            else:
                self.motor_status_var.set(f"⚠️ {response.strip()}")
        except Exception as exc:
            self.motor_status_var.set(f"❌ Error: {exc}")

    # ------------------------------------------------------------------
    # Queue processing and UI updates
    # ------------------------------------------------------------------
            self._reader_thread = None
        self.connect_button.config(text="Connect")
        self.status_var.set("Disconnected")

    # ------------------------------------------------------------------
    # Queue processing and UI updates
    # ------------------------------------------------------------------
    def _schedule_queue_processing(self) -> None:
        self.after(100, self._process_queue)

    def _process_queue(self) -> None:
        while True:
            try:
                item = self._queue.get_nowait()
            except queue.Empty:
                break

            if isinstance(item, Exception):
                self.status_var.set(str(item))
                if isinstance(item, json.JSONDecodeError):
                    continue
                messagebox.showerror("Connection Error", str(item))
                self._disconnect()
                break
            
            # Check if this is an acknowledgment message (not telemetry)
            if isinstance(item, dict) and item.get("_type") == "ack":
                self._handle_acknowledgment(item["payload"])
                continue

            assert isinstance(item, TelemetryPacket)
            self._update_display(item)

        self._schedule_queue_processing()
    
    def _handle_acknowledgment(self, payload: dict) -> None:
        """Handle acknowledgment or error response from Arduino firmware.
        
        Args:
            payload: JSON payload containing 'ack' or 'error' fields
        """
        if "ack" in payload:
            # Successful command acknowledgment
            if payload["ack"] == "set_threshold":
                sensor = payload.get("sensor", 0)
                if payload.get("status") == "ok":
                    value = payload.get("value", 0)
                    # Update displayed firmware threshold to the confirmed value
                    try:
                        current_thresholds = self.firmware_ir_threshold_var.get()
                        if current_thresholds == "-":
                            thresholds_list = ["-"] * 4
                        else:
                            thresholds_list = current_thresholds.split(", ")
                        thresholds_list[sensor] = f"{float(value):.2f}V"
                        self.firmware_ir_threshold_var.set(", ".join(thresholds_list))
                    except Exception:
                        self.firmware_ir_threshold_var.set(str(value))
                    self.status_var.set(f"✅ Sensor {sensor} threshold updated: {float(value):.2f}V")
                    print(f"[TCP] Firmware confirmed sensor {sensor} threshold: {value:.2f}V")
                else:
                    # Error response from firmware
                    error = payload.get("error", "unknown")
                    if error == "invalid_range":
                        min_val = payload.get("min", 0.1)
                        max_val = payload.get("max", 4.0)
                        self.status_var.set(f"❌ Sensor {sensor} invalid range. Min: {min_val}V, Max: {max_val}V")
                    else:
                        self.status_var.set(f"❌ Sensor {sensor} error: {error}")
                    print(f"[TCP] Firmware error for sensor {sensor}: {error}")
        elif "error" in payload:
            # General error response
            error_msg = payload.get("error", "unknown")
            self.status_var.set(f"❌ Error: {error_msg}")
            print(f"[TCP] Error response: {error_msg}")

    def _update_display(self, packet: TelemetryPacket) -> None:
        # Store packet for threshold marker redraws
        self._last_packet = packet
        
        self.timestamp_var.set(f"{packet.timestamp}")
        self.status_var.set(time.strftime("Last update: %H:%M:%S"))
        
        # Display firmware threshold values (only initially from telemetry)
        if not self.initial_threshold_displayed:
            thresholds_str = ", ".join(f"{t:.2f}V" for t in packet.ir_edge_thresholds)
            self.firmware_ir_threshold_var.set(thresholds_str)
            self.initial_threshold_displayed = True
        # Note: ToF detection threshold is not displayed in UI currently
        # Update IR sensor data with color-coded bars
        for idx in range(4):
            raw_value = packet.sensors_raw[idx] if idx < len(packet.sensors_raw) else "-"
            volt_value = packet.sensors_voltage[idx] if idx < len(packet.sensors_voltage) else "-"
            self.sensor_raw_labels[idx].set(str(raw_value))
            self.sensor_voltage_labels[idx].set(f"{volt_value:.3f}" if isinstance(volt_value, (float, int)) else str(volt_value))
            
            # Update Canvas-based voltage bar and color based on sensor-specific color
            if isinstance(volt_value, (float, int)):
                bar_value = max(0.0, min(4.096, float(volt_value)))
                
                # Use sensor-specific color for the bar
                fill_color = self.sensor_colors[idx]
                
                # Draw voltage bar on Canvas
                self._draw_voltage_bar(idx, bar_value, fill_color)
            else:
                # No valid data, show empty bar with sensor color
                self._draw_voltage_bar(idx, 0.0, self.sensor_colors[idx])

        # Update ToF sensor data with color-coded bars
        for idx in range(3):
            distance_value = packet.tof_distances[idx] if idx < len(packet.tof_distances) else "-"
            valid = packet.tof_valid[idx] if idx < len(packet.tof_valid) else False
            status = packet.tof_status[idx] if idx < len(packet.tof_status) else "-"
            
            if isinstance(distance_value, int) and valid:
                self.tof_distance_labels[idx].set(f"{distance_value} mm")
                self.tof_status_labels[idx].set("✓ Valid")
                # Update proximity bar (inverse: closer = more filled)
                # Clamp distance to 0-1500mm, then invert so bar fills as object approaches
                proximity_value = max(0, 1500 - min(1500, distance_value))
                self.tof_proximity_bars[idx]['value'] = proximity_value
                
                # Determine color zone based on actual distance (not proximity):
                # Green (>=1000mm far) → Yellow (350-999mm medium) → Red (<350mm close)
                if distance_value >= 1000:
                    self.tof_proximity_bars[idx].configure(style='ToF.green.Horizontal.TProgressbar')
                elif distance_value >= 350:
                    self.tof_proximity_bars[idx].configure(style='ToF.yellow.Horizontal.TProgressbar')
                else:
                    self.tof_proximity_bars[idx].configure(style='ToF.red.Horizontal.TProgressbar')
            else:
                self.tof_distance_labels[idx].set("-")
                self.tof_status_labels[idx].set(f"Error ({status})" if status != "-" else "-")
                self.tof_proximity_bars[idx]['value'] = 0
                self.tof_proximity_bars[idx].configure(style='ToF.green.Horizontal.TProgressbar')
        
        # Update ToF object direction
        self.tof_object_direction_var.set(packet.tof_object_direction if packet.tof_object_direction else "-")

        self.action_var.set(packet.robot_state.get("action", "-"))
        self.edge_detected_var.set(str(packet.robot_state.get("edge_detected", "-")))
        self.edge_direction_var.set(packet.robot_state.get("edge_direction", "-"))
        self.danger_level_var.set(str(packet.robot_state.get("danger_level", "-")))

        self.core0_freq_var.set(str(packet.system_info.get("core0_freq", "-")))
        self.core1_freq_var.set(str(packet.system_info.get("core1_freq", "-")))
        self.wifi_rssi_var.set(str(packet.system_info.get("wifi_rssi", "-")))
        self.free_heap_var.set(str(packet.system_info.get("free_heap", "-")))
        
        # Update test mode status from telemetry
        if packet.test_mode:
            self.mode_status_var.set(f"Current: {packet.test_mode}")
            # Also update the dropdown to reflect current mode
            if packet.test_mode in ["AUTO", "TEST_MOTOR", "TEST_SENSOR", "CALIBRATE_IR", "CALIBRATE_TOF"]:
                self.test_mode_var.set(packet.test_mode)
        
        # Update motor status indicators
        if packet.motor_estop:
            self.motor_status_var.set(f"🛑 E-STOP | M1:{packet.motor_left} M2:{packet.motor_right}")
        else:
            self.motor_status_var.set(f"✓ Active | M1:{packet.motor_left} M2:{packet.motor_right}")

    # ------------------------------------------------------------------
    # Tkinter lifecycle hooks
    # ------------------------------------------------------------------
    def destroy(self) -> None:
        self._disconnect()
        super().destroy()


def main() -> None:
    app = BottleSumoViewer()
    app.mainloop()


if __name__ == "__main__":
    main()
