wedsamuel1230/CTEA-BottleSumo/software/testing/LineTracker/LineTracker.ino

void setup() {
  Serial.begin(9600); // Initialize serial communication
  analogReadResolution(12);
}

int check_line_tracker(float thershold){
  byte result;
  int sensorValue = analogRead(A0); // Read analog value from ADC0 (GP26)
  // Convert the analog value to voltage
  float voltage = (sensorValue / 4095.0) * 5; 
  /*
  Serial.print("Analog Value: ");
  Serial.print(sensorValue);
  Serial.print(", Voltage: ");
  Serial.print(voltage, 2); // Print voltage with 2 decimal places
  Serial.println("V");*/

  if(voltage >= thershold){
    Serial.println("Out of bounds");
    result = result + 1;
  }
  else
  {
    Serial.println("Okay");
  }
  return result;
}

void loop() {
  Serial.println("Result(Binary): ");
  Serial.println(check_line_tracker(2.5), BIN);
  Serial.print("Result: ");
  Serial.println(check_line_tracker(2.5));
  delay(100); // Small delay for stable readings
}
