wedsamuel1230/CTEA-BottleSumo/(commit log)

2025-09-08 Add voltage bounds check
2025-09-08 Add state combination Arduino sketch
2025-09-11 update for TOF sensor
2025-09-12 update motor
2025-09-12 Enable OLED display and update TOF testing setup
    Uncommented and initialized SSD1306 OLED display in TOF_testing.ino, added display setup and test output. Commented out unused motor functions in TOG_AddressChange_Test.ino. Moved ToF_AddressChanger.ino into a subdirectory. Added Theia launch configuration.
2025-09-17 Update motor_test.ino:introduced move_straight function
2025-09-22 Refactor motor pin definitions and usage
    Renamed motor pin variables for clarity and updated their usage in both 2motor_test.ino and motor_test.ino. Added input pull-up configuration for the button and improved code readability by commenting out unused sections.
2025-09-22 Add comprehensive ADS1115 4-channel ADC support for Raspberry Pi Pico
2025-09-22 Remove legacy ADS1115 examples and add new sketches
    Deleted old ADS1115 example sketches (I2C scanner, library example, line tracker, and test) and added new single-ended ADS1115 example and a QRE1113 line sensor sketch with custom I2C pin configuration. This update streamlines the codebase and introduces improved sensor reading and line detection logic.
2025-09-22 Add BottleSumo QRE1113 edge detection and refactor
    Added BottleSumo_QRE1113.ino implementing edge detection and tactical logic for Bottle Sumo robots using ADS1115 and QRE1113 sensors. Added VSCode MicroPython settings. Refactored and expanded sketch_sep22a.ino with new sensor structures, tactical logic, and performance analysis. Renamed singleended.ino and motor_test.ino to new directories for better organization.
2025-09-23 新增雙核心架構支援，優化感測器讀取與數據同步
2025-09-23 Add OLED display integration to BottleSumo robot
    Integrated SSD1306 OLED display for real-time system and tactical status visualization. Updated hardware pin mappings, initialization routines, and main loop to support OLED updates at 5Hz. Enhanced documentation and comments to reflect new display features and required libraries. Also moved motor_test.ino to a new directory.
2025-09-23 successfully run 3 sensors
2025-09-24 Add BottleSumo QRE1113 sensor and OLED projects
    Added new Arduino projects for BottleSumo robots: 'SensorOnly' and 'with_OLED' variants, each with their own .ino source and VSCode settings. Also added a WiFiServer_test and test_simple project. These changes introduce dual-core sensor reading, OLED display support, and example code for advanced edge detection and tactical control.
2025-09-25 Add real-time streaming test script for robot state and sensor data
    - Implemented a socket connection to receive data from the robot.
    - Parsed incoming JSON data to extract and print robot action and sensor voltage.
    - Added a loop to continuously receive and process data with a delay.
2025-09-29 updated motor_test
2025-09-29 Update sensor frequency to 155.5Hz in docs and code
    Revised all references to sensor reading frequency from 860Hz to 155.5Hz in LaTeX analysis, Arduino source files, and display outputs to reflect actual measured performance. Also updated WiFi credentials placeholder and removed the README_Analysis.md documentation file. Minor cleanup in test.py.
2025-10-01 Add Bottle Sumo real-time telemetry viewer
    Introduces a Tkinter-based GUI for monitoring Bottle Sumo robot telemetry via TCP streaming. Includes connection controls, live sensor and system readouts, and error handling. Initial documentation and implementation provided.
    [viewer.py]
2025-10-02 updated tof sensor setting
2025-10-02 Remove ToF sensor integration from main streaming code
    All VL53L0X ToF sensor code, data structures, and related logic have been removed from BottleSumo_RealTime_Streaming.ino. The main streaming code now only handles IR sensor data. Additionally, TOF_Sensors.ino was moved to a subdirectory and a call to scanI2C() was added in its setup routine.
2025-10-02 tof sensor (serial) updated and adding pico w ap mode
2025-10-04 Remove analysis files and add new sensor code
    Deleted BottleSumo_Analysis.pdf, BottleSumo_Analysis.tex, and TOF_Sensors.ino. Added TOF_Sensors_WiFi_AP.ino and tempsave.txt. Updated instructions and BottleSumo_RealTime_Streaming.ino to reflect new sensor integration and documentation.
2025-10-04 Refactor ToF sensor handling and optimize updates
    Replaced ToF sensor code with explicit sequential initialization, updated I2C addresses, and switched to fast mode (100ms timing budget) for improved range. Separated IR and ToF sensor update functions to allow high-speed IR readings (~860Hz) and slower ToF updates (~10Hz), optimizing Core 1 loop performance and responsiveness. Added TOF_UPDATE_SUMMARY.md documenting changes and improvements.
2025-10-05 Refactor ToF sensor code for ultra fast mode and mutex safety
    Replaced ToF sensor initialization and timing logic with proven ultra fast (20ms) implementation, consolidated configuration constants to constexpr style, and added Wire1 I2C bus mutex for dual-core safety. Reduced OLED update frequency to minimize I2C blocking, fixed ToF loop timing to match actual sensor read duration, and removed duplicate/conflicting code. Added technical documentation and bug fix reports for improved maintainability and performance.
    [viewer.py]
2025-10-05 Add color-coded and draggable IR threshold UI
    Implemented color-coded progress bars and draggable threshold markers for IR sensors in the Python telemetry viewer. Updated Arduino firmware to stream threshold values in JSON payloads. Viewer now supports interactive threshold adjustment via drag-and-drop and remains backward compatible with older firmware.
2025-10-05 Update IR sensor voltage range to 4.096V
    Changed IR sensor progress bar, threshold spinbox, and related calculations from a 3.3V to a 4.096V maximum to match hardware capabilities. Added _apply_threshold_changes method to prepare for future runtime firmware threshold updates. Improved threshold marker visibility and updated voltage calculations throughout the viewer.
2025-10-05 Improve voltage bar container UI and clarify ToF threshold
    Added sunken relief and border to the voltage bar container for better visual separation. Clarified in code that the ToF detection threshold is not currently displayed in the UI.
2025-10-05 Remove test and implementation docs for color-coded and draggable threshold features
    Deleted markdown documentation and test scripts related to color-coded progress bars, draggable threshold markers, and quantization in the realtime_monitor directory. Updated viewer.py to use a single Canvas for both voltage bar and threshold marker, refactored drawing logic, and improved threshold marker visibility. Minor changes in the Arduino firmware to remove threshold fields from JSON payloads.
2025-10-05 Swap ToF sensor shutdown pin assignments
    Corrects the pin assignments for the right and front ToF sensor shutdown pins, swapping GP11 and GP12 to match hardware configuration.
2025-10-05 Add runtime edge threshold control via TCP command
    Introduces thread-safe runtime configuration for the edge detection threshold in the Arduino firmware, allowing it to be updated via TCP commands from the GUI. Updates the viewer.py GUI to send threshold change commands and handle acknowledgments/errors from the firmware. Refactors related sensor logic to use the runtime threshold, and improves ToF sensor bar color zones for better feedback.
    [viewer.py]
2025-10-05 Improve ToF sensor config and JSON command parsing
    Adjusted ToF sensor timing for balanced mode and improved long-range accuracy. Enhanced JSON command parsing in firmware to handle spaces and malformed input. Updated Python viewer to immediately reflect threshold changes in the UI and handle value conversion more robustly.
2025-10-05 Show firmware threshold only on initial telemetry update
    Added a flag to ensure the firmware IR threshold value is displayed only on the first telemetry packet received, preventing repeated updates in the UI.
    [viewer.py]
2025-10-05 Add per-sensor IR threshold configuration and UI
    Firmware and viewer now support individual IR edge thresholds for each sensor, configurable via TCP commands and the GUI. The Arduino code refactors threshold handling to use an array, updates JSON streaming, and maintains backward compatibility for legacy commands. The Python viewer UI is updated to allow per-sensor threshold adjustment, sending separate commands for each sensor, and displays firmware thresholds for all sensors. Documentation and architecture diagrams are added to the docs directory.
2025-10-05 Support per-sensor IR edge threshold configuration
    Refactored TelemetryPacket to handle individual IR edge thresholds for each sensor, supporting both legacy single-value and new list-based firmware formats. Updated the UI to allow applying thresholds per sensor and display firmware thresholds for all sensors. Added methods to send threshold commands for individual sensors over TCP.
2025-10-06 Add RP2040 dual-core firmware and docs
    Introduces BottleSumo_RP2040_DualCore.ino implementing a lockless dual-core architecture for sensor fusion and tactical control on Raspberry Pi Pico W. Updates snapshot firmware to use VL53L0X library. Adds detailed architecture and verification documentation for real-time streaming and RP2040 design.
2025-10-13 update for 5 sensors
2025-10-13 add a tof sensor test
2025-10-14 Add QRE1113 v4 3D model file
    Added the QRE1113 v4.f3d file to the 3dmodel directory. Other changes are to .DS_Store files, which are system-generated and not relevant to the project.
    [QRE1113 v4.f3d]
2025-10-15 Add Motor control class and example for Arduino
    Introduces a Motor class for PWM-based motor control with direction and speed settings. Includes implementation files (Motor.cpp, Motor.h) and an example sketch (motor.ino) demonstrating basic car movement functions such as forward, backward, stop, and turning.
2025-10-15 Implement WiFi control and GUI for motor commands; add TCP server functionality and JSON parsing for command handling
2025-10-15 feat(gui): add motor control UI and JSON command verification tests
2025-10-15 Integrate modular test mode for motor and sensor
    Added modular test mode framework to BottleSumo_RealTime_Streaming, including MotorTestMode, SensorTestMode, and TestModeCommon header modules. Integrated direct motor and sensor test commands into the TCP interface, with safety features such as timeout and emergency stop. Updated main loop and setup for test mode execution and motor initialization. Migrated Motor driver files and documentation, and provided comprehensive guides for integration and usage.
2025-10-16 changed the tof sensors test mode
2025-10-16 Add PCB schematic and new component libraries
    Added 'Test PCB Schematic v9' project file and footprint libraries for QRE1113 and Raspberry Pi Pico to the pcb directory.
    [Test PCB Schematic v9.f3z]
2025-10-16 Update QRE1113 footprint library file
    The QRE1113.flbr footprint library file has been updated. Details of the changes are not visible due to the binary format.
2025-10-16 Add ADS1115 and VL53L0X footprint libraries
    Introduced new footprint library files for the ADS1115 ADC and VL53L0X sensor to support PCB design integration.
2025-10-16 Add new 3D models and update library files
    Added 3D models for MOTOR STAND 28GP, Motor 28GP, Pico-R3, and PicoW. Renamed QRE1113 v4.f3d to Parts model directory. Updated VL53L0X Library footprint file.
    [MOTOR STAND 28GP v1.f3d, Motor 28GP v1.f3d, Pico-R3 v1.f3d, PicoW v1.f3d, QRE1113 v4.f3d]
2025-10-18 Refactor and relocate testing and motor software
    Moved all testing and motor-related files into the software/testing directory for better organization. Updated TOF_Sensors_WiFi_AP.ino to support 5 sensors in maximum range mode and removed WiFi/web server functionality. Added new 3D model and competition documents.
    [VL53L0X_TOF.f3d]
2025-10-19 Implement directional edge detection and retreat logic
    Expanded edge detection in BottleSumo_TimeSliced.ino to support directional retreat actions using a bitfield pattern for 4 IR sensors. Updated SumoAction enum, added EdgeDetection struct and analyzeEdges() function, and rewrote decideAction() and executeAction() for precise motor control based on edge patterns. Enhanced telemetry and logging, and added comprehensive documentation and architecture diagrams for the new system.
    [16Bit I2C ADC+PGA - ADS1115 v4.f3d, VL53L0X_TOF v2.f3d, VL53L0X_TOF.f3d]
2025-10-20 Add STEP files for ss12d06 and ss12d10 parts
    Added 3D model STEP files for ss12d06 and ss12d10 switches to the 'Parts model' directory for use in CAD and mechanical design.
    [ss12d06.stp, ss12d10.stp]
2025-10-20 Add BottleSumo Library.flbr to PCB library
    Introduces a new footprint library file 'BottleSumo Library.flbr' to the PCB library directory for use in PCB design.
2025-10-20 Update BottleSumo Library footprint file
    Replaces the existing BottleSumo Library.flbr file with a new version. This may include updated or additional PCB footprints for the BottleSumo project.
2025-10-27 Add BottleSumo Motor TCP test project and prompts
    Introduces the BottleSumo_Motor_Tcp_test project with Arduino, C++, and Python source files, documentation, and test scripts. Adds Speckit prompt templates for analysis, checklist, clarification, constitution, implementation, planning, specification, and tasks. Also includes VSCode MicroPython settings and updates a related test sketch.
2025-10-28 Add motor control and PCB design files
    Added initial motor control source files (Motor.cpp, Motor.h, Motor_test.ino) for Arduino-based motor testing. Included PCB design rules, images, and 3D model DXF for hardware development. Also added tool library and various .DS_Store files.
    [Sketch1.dxf]
2025-10-29 Add I2C pin constants and update Wire1 init
    Introduced I2C_SDA and I2C_SCL constants for I2C pin configuration. Updated initWire1 to use these constants instead of hardcoded values for improved maintainability.
2025-10-29 Replace TcpMotorControl with new Library-based motor control
    Removed the TcpMotorControl implementation and related files, including custom Motor and controller classes, and added a new modular motor control library under software/Library. The new library provides Car and Motor classes with improved initialization, error handling, and PWM configuration for RP2040, along with an example sketch and architecture diagram. This refactor transitions motor control to a reusable, hardware-agnostic library for future development.
    [Motor.cpp, Motor.h, TcpMotorControl.ino, command_parser.cpp, command_parser.h, motor_controller.cpp, motor_controller.h]
2025-10-31 Remove obsolete comments and endif guards
    Deleted legacy #endif guards and outdated comments from Car.h and Motor.h to clean up the codebase and improve readability.
2025-11-06 Add sensor library and examples, remove Motor_test
    Introduced Ads1115Sampler and ToFArray sensor drivers with example sketches for non-blocking sensor reading and autonomous robot control. Added documentation and a Python test script. Removed the Motor_test directory and related files. Updated .DS_Store files.
2025-11-06 Add non-blocking ADC API and update examples
    Introduces a non-blocking API to Ads1115Sampler for asynchronous ADC channel reads, including startConversion and poll methods. Updates all relevant examples (Minimal_SensorTest, RobotControl_Autonomous, SensorArray_NonBlocking) to use the new non-blocking ADC approach, improving performance and responsiveness. Adds ToFArray utility for scalable VL53L0X sensor management in Minimal_SensorTest. Also updates I2C initialization in ads1115_with_qre1113.ino for compatibility with custom I2C pins.
2025-11-10 Create Top Cover.3mf
    [Top Cover.3mf]
2025-11-10 Improve sensor initialization and ADC timeout handling
    Extended ToF sensor reset and post-reset delays for more reliable startup and I2C stability. Added conversion timeout logic to Ads1115Sampler for safer non-blocking ADC reads. Updated Minimal_SensorTest example to clarify ToF configuration, initialization order, and output formatting. Changed Wire1 pin assignments in test sketches for consistency. Removed obsolete TOF address change test files.
    [TOF_AddressChange_test2.ino, TOF_Sensors_Test.ino, TOF_testing.ino, TOG_AddressChange_Test.ino]
2025-11-10 Expand ToF sensor support to 5 sensors
    Updated configuration to support five ToF sensors with distinct XSHUT pins and I2C addresses. Adjusted read and print logic to handle multiple sensors instead of just one.
2025-11-11 Add ADS1115 and VL53L0X sensor array libraries
    Introduces Ads1115Sampler and ToFArray classes for managing ADS1115 ADC and VL53L0X ToF sensor arrays, respectively. These libraries provide initialization, configuration, and multi-channel readout functionality for sensor integration. Also adds an empty car_ir.ino sketch as a starting point.
2025-11-11 Add car IR sensor control with motor and ADC classes
    Introduces Ads1115Sampler, Motor, and Car classes for modular control of motors and IR sensor sampling. Implements main logic in car_ir.ino for IR-based navigation, including non-blocking search mode and sensor-based movement decisions. Adds VSCode settings for MicroPython development.
2025-11-11 motor test and ir pk logic change
2025-11-11 motor test
2025-11-11 motor turn left turn right
2025-11-11 final tuned the motor direction
2025-11-11 ir sensor not pk any more
2025-11-14 ir sensors updated settting
2025-11-17 tof sensor update
2025-11-18 Add simple car tracking implementation
    Removed old telemetry viewer scripts and PCB gcode file. Added new 'simple_car_tracking' module with classes for car, motor, ADS1115 sampling, ToF sensor array, and Arduino sketch, along with documentation.
2025-11-18 Update car tracking parameters and improve sensor configurations
2025-11-19 Revert "Update simple_car_tracking.ino"
    This reverts commit 8e5deaf4a30c6ac9800ca0a4f3d9e113e7f87f87.
    [simple_car_tracking.ino]
2025-11-19 Add sumo robot main code and supporting modules
    Added main.ino and supporting modules for sumo robot, including HuskyLens integration, motor control, button handling, WiFi server, light sensor, and IO light. Also fixed a typo in simple_car_tracking.ino. These changes provide the foundation for robot control, sensor integration, and remote operation.
    [HUSKYLENS.h, HuskyLensProtocolCore.c, Motor.cpp, Motor.h, Wifi_server.cpp, Wifi_server.h, button.cpp]
2025-11-19 tof sensor can follow the bottle version
2025-11-21 wrong path of car final
    [Ads1115Sampler.cpp, Ads1115Sampler.h, ButtonManager.h, CAR_final.ino, CAR_final_v2.ino, Car.cpp, Car.h, Motor.cpp]
2025-11-21 Add IR car control with hardcoded forward logic
    Introduced a new 'ir_with_hardcode_forward' project with modular classes for motor and IR sensor control (Car, Motor, Ads1115Sampler). Implements edge detection, dynamic threshold calibration, and a hardcoded forward sequence triggered by button press. Existing car_ir.ino updated with minor formatting changes.
2025-11-22 Add new IR and ToF car control implementation
    Introduces a new directory 'ir_with_hardcode_forward_and_1_tof' with modular motor, car, and ADS1115 sensor classes, and a main control sketch integrating IR and ToF sensor logic for car movement. Also updates 'ir_with_hardcode_forward.ino' to improve start button handling and hardcoded movement sequence, and adds a backup of previous logic in 'backup.txt'.
2025-12-06 Remove outdated files and add new models and tests
    Deleted various outdated files and directories, including old 3D models, PCB files, and test scripts. Added new 3D model OBJ files, updated PCB documentation, and introduced new example and test files for motor and sensor functionality. Refactored and reorganized code and documentation into 'outdated' directories for archival purposes.
    [16Bit I2C ADC+PGA - ADS1115 v4.f3d, Car1_Front_Cover.obj, Car2_Front_Cover.obj, Car_Back_Cover.obj, MOTOR STAND 28GP v1.f3d, Motor 28GP v1.f3d, Pico-R3 v1.f3d, PicoW v1.f3d]
